Embedfire-stm32f407-batianhu/ebf_stm32f407_batianhu_hardware/hardware/F407板载IC数据手册/4.3寸电容屏/4.3寸液晶模块与STM32F407接线方式.xls

4.5寸液晶模块与野火STM32开发板连接方式，如果只是单独购买了液晶模块，可参考下面的接线方式。
F407霸天虎 |  |  |  | 103霸道 |  |  |  | 103指南者
引脚序号 | 引脚说明 | 引脚名称 | F407（霸天虎） | 引脚序号 | 引脚说明 | 引脚名称 | 103（霸道） | 引脚序号 | 引脚说明 | 引脚名称 | 103（指南者）
1 | GND | 地 | GND | 1 | GND | 地 | GND | 1 | GND | 地 | GND
2 | RES | 复位 | PF11 | 2 | RES | 复位 | PG11 | 2 | RES | 复位 | PE1
3 | D15 | 数据15 | PD10 | 3 | D15 | 数据15 | PD10 | 3 | D15 | 数据15 | PD10
4 | D14 | 数据14 | PD9 | 4 | D14 | 数据14 | PD9 | 4 | D14 | 数据14 | PD9
5 | D13 | 数据13 | PD8 | 5 | D13 | 数据13 | PD8 | 5 | D13 | 数据13 | PD8
6 | D12 | 数据12 | PE15 | 6 | D12 | 数据12 | PE15 | 6 | D12 | 数据12 | PE15
7 | D11 | 数据11 | PE14 | 7 | D11 | 数据11 | PE14 | 7 | D11 | 数据11 | PE14
8 | D10 | 数据10 | PE13 | 8 | D10 | 数据10 | PE13 | 8 | D10 | 数据10 | PE13
9 | D09 | 数据9 | PE12 | 9 | D10 | 数据9 | PE12 | 9 | D10 | 数据9 | PE12
10 | D08 | 数据8 | PE11 | 10 | D08 | 数据8 | PE11 | 10 | D08 | 数据8 | PE11
11 | D07 | 数据7 | PE10 | 11 | D07 | 数据7 | PE10 | 11 | D07 | 数据7 | PE10
12 | D06 | 数据6 | PE9 | 12 | D06 | 数据6 | PE9 | 12 | D06 | 数据6 | PE9
13 | D05 | 数据5 | PE8 | 13 | D05 | 数据5 | PE8 | 13 | D05 | 数据5 | PE8
14 | D04 | 数据4 | PE7 | 14 | D04 | 数据4 | PE7 | 14 | D04 | 数据4 | PE7
15 | D03 | 数据3 | PD1 | 15 | D03 | 数据3 | PD1 | 15 | D03 | 数据3 | PD1
16 | D02 | 数据2 | PD0 | 16 | D02 | 数据2 | PD0 | 16 | D02 | 数据2 | PD0
17 | D01 | 数据1 | PD15 | 17 | D01 | 数据1 | PD15 | 17 | D01 | 数据1 | PD15
18 | D00 | 数据0 | PD14 | 18 | D00 | 数据0 | PD14 | 18 | D00 | 数据0 | PD14
19 | RD | 读使能 | PD4 | 19 | RD | 读使能 | PD4 | 19 | RD | 读使能 | PD4
20 | WR | 写使能 | PD5 | 20 | WR | 写使能 | PD5 | 20 | WR | 写使能 | PD5
21 | RS | 数据命令选择 | PF0 | 21 | RS | 数据命令选择 | PE2 | 21 | RS | 数据命令选择 | PD11
22 | CS | 片选 | PG10 | 22 | CS | 片选 | PG12 | 22 | CS | 片选 | PD7
23 | NC | 空引脚，不需要连接 | PG9 | 23 | NC | 空引脚，不需要连接 | PG9 | 23 | NC | 空引脚，不需要连接 | PG9
24 | SCL | 电容屏时钟:I2C_SCL | PD7 | 24 | SCL | 电容屏时钟:I2C_SCL | PF10 | 24 | SCL | 电容屏时钟:I2C_SCL | PD13
25 | RST | 电容屏复位 | PD6 | 25 | RST | 电容屏复位 | PF11 | 25 | RST | 电容屏复位 | PE3
26 | PD3 | 电容屏数据:I2C_SDA | PD3 | 26 | PD3 | 电容屏数据:I2C_SDA | PF6 | 26 | PD3 | 电容屏数据:I2C_SDA | PE2
27 | INT | 电容屏中断：INT | PG8 | 27 | INT | 电容屏中断：INT | PF9 | 27 | INT | 电容屏中断：INT | PE4
28 | BK | 背光，低电平亮 | PF9 | 28 | BK | 背光，低电平亮 | PG6 | 28 | BK | 背光，低电平亮 | PD12
29 | NC | 悬空 | NC | 29 | NC | 悬空 | NC | 29 | NC | 悬空 | NC
30 | NC | 悬空 | NC | 30 | NC | 悬空 | NC | 30 | NC | 悬空 | NC
31 | 3V3 | 电源 | 3V3 | 31 | 3V3 | 电源 | 3V3 | 31 | 3V3 | 电源 | 3V3
32 | GND | 地 | GND | 32 | GND | 地 | GND | 32 | GND | 地 | GND
