Embedfire-stm32f407-batianhu/ebf_stm32f407_batianhu_hardware/(list of files, cad)

Other CAD files:
hardware/F407_霸天虎V2/封装库/野火_F407霸天虎_V2_0_封装库/CADENCE格式/野火_F407霸天虎_V2_0_PCB封装库_Allegro格式/3215.psm
hardware/F407_霸天虎V2/封装库/野火_F407霸天虎_V2_0_封装库/CADENCE格式/野火_F407霸天虎_V2_0_PCB封装库_Allegro格式/3225.psm
hardware/F407_霸天虎V2/封装库/野火_F407霸天虎_V2_0_封装库/CADENCE格式/野火_F407霸天虎_V2_0_PCB封装库_Allegro格式/ant_dip2.psm
hardware/F407_霸天虎V2/封装库/野火_F407霸天虎_V2_0_封装库/CADENCE格式/野火_F407霸天虎_V2_0_PCB封装库_Allegro格式/ap3216c.psm
hardware/F407_霸天虎V2/封装库/野火_F407霸天虎_V2_0_封装库/CADENCE格式/野火_F407霸天虎_V2_0_PCB封装库_Allegro格式/buzzer.psm
hardware/F407_霸天虎V2/封装库/野火_F407霸天虎_V2_0_封装库/CADENCE格式/野火_F407霸天虎_V2_0_PCB封装库_Allegro格式/c0603.psm
hardware/F407_霸天虎V2/封装库/野火_F407霸天虎_V2_0_封装库/CADENCE格式/野火_F407霸天虎_V2_0_PCB封装库_Allegro格式/cap100.psm
hardware/F407_霸天虎V2/封装库/野火_F407霸天虎_V2_0_封装库/CADENCE格式/野火_F407霸天虎_V2_0_PCB封装库_Allegro格式/con_2pin.psm
hardware/F407_霸天虎V2/封装库/野火_F407霸天虎_V2_0_封装库/CADENCE格式/野火_F407霸天虎_V2_0_PCB封装库_Allegro格式/cr1220.psm
hardware/F407_霸天虎V2/封装库/野火_F407霸天虎_V2_0_封装库/CADENCE格式/野火_F407霸天虎_V2_0_PCB封装库_Allegro格式/d1206.psm
hardware/F407_霸天虎V2/封装库/野火_F407霸天虎_V2_0_封装库/CADENCE格式/野火_F407霸天虎_V2_0_PCB封装库_Allegro格式/db9-f.psm
hardware/F407_霸天虎V2/封装库/野火_F407霸天虎_V2_0_封装库/CADENCE格式/野火_F407霸天虎_V2_0_PCB封装库_Allegro格式/db9-m.psm
hardware/F407_霸天虎V2/封装库/野火_F407霸天虎_V2_0_封装库/CADENCE格式/野火_F407霸天虎_V2_0_PCB封装库_Allegro格式/dip-2x10-2p54.psm
hardware/F407_霸天虎V2/封装库/野火_F407霸天虎_V2_0_封装库/CADENCE格式/野火_F407霸天虎_V2_0_PCB封装库_Allegro格式/dip-2x16-2p54.psm
hardware/F407_霸天虎V2/封装库/野火_F407霸天虎_V2_0_封装库/CADENCE格式/野火_F407霸天虎_V2_0_PCB封装库_Allegro格式/dip-2x302p54.psm
hardware/F407_霸天虎V2/封装库/野火_F407霸天虎_V2_0_封装库/CADENCE格式/野火_F407霸天虎_V2_0_PCB封装库_Allegro格式/dip-2x4-2p54.psm
hardware/F407_霸天虎V2/封装库/野火_F407霸天虎_V2_0_封装库/CADENCE格式/野火_F407霸天虎_V2_0_PCB封装库_Allegro格式/do214.psm
hardware/F407_霸天虎V2/封装库/野火_F407霸天虎_V2_0_封装库/CADENCE格式/野火_F407霸天虎_V2_0_PCB封装库_Allegro格式/ear_jack.psm
hardware/F407_霸天虎V2/封装库/野火_F407霸天虎_V2_0_封装库/CADENCE格式/野火_F407霸天虎_V2_0_PCB封装库_Allegro格式/ec6p3.psm
hardware/F407_霸天虎V2/封装库/野火_F407霸天虎_V2_0_封装库/CADENCE格式/野火_F407霸天虎_V2_0_PCB封装库_Allegro格式/f0805.psm
hardware/F407_霸天虎V2/封装库/野火_F407霸天虎_V2_0_封装库/CADENCE格式/野火_F407霸天虎_V2_0_PCB封装库_Allegro格式/gxd.psm
hardware/F407_霸天虎V2/封装库/野火_F407霸天虎_V2_0_封装库/CADENCE格式/野火_F407霸天虎_V2_0_PCB封装库_Allegro格式/hdr102.psm
hardware/F407_霸天虎V2/封装库/野火_F407霸天虎_V2_0_封装库/CADENCE格式/野火_F407霸天虎_V2_0_PCB封装库_Allegro格式/jack-2_5mm_b.psm
hardware/F407_霸天虎V2/封装库/野火_F407霸天虎_V2_0_封装库/CADENCE格式/野火_F407霸天虎_V2_0_PCB封装库_Allegro格式/jtag_20pin.psm
hardware/F407_霸天虎V2/封装库/野火_F407霸天虎_V2_0_封装库/CADENCE格式/野火_F407霸天虎_V2_0_PCB封装库_Allegro格式/l0603.psm
hardware/F407_霸天虎V2/封装库/野火_F407霸天虎_V2_0_封装库/CADENCE格式/野火_F407霸天虎_V2_0_PCB封装库_Allegro格式/l1040.psm
hardware/F407_霸天虎V2/封装库/野火_F407霸天虎_V2_0_封装库/CADENCE格式/野火_F407霸天虎_V2_0_PCB封装库_Allegro格式/led0603.psm
hardware/F407_霸天虎V2/封装库/野火_F407霸天虎_V2_0_封装库/CADENCE格式/野火_F407霸天虎_V2_0_PCB封装库_Allegro格式/led_rgb_5mm.psm
hardware/F407_霸天虎V2/封装库/野火_F407霸天虎_V2_0_封装库/CADENCE格式/野火_F407霸天虎_V2_0_PCB封装库_Allegro格式/lqfp144-050-2020.psm
hardware/F407_霸天虎V2/封装库/野火_F407霸天虎_V2_0_封装库/CADENCE格式/野火_F407霸天虎_V2_0_PCB封装库_Allegro格式/mic_6x2_2.psm
hardware/F407_霸天虎V2/封装库/野火_F407霸天虎_V2_0_封装库/CADENCE格式/野火_F407霸天虎_V2_0_PCB封装库_Allegro格式/micro_usb_5s.psm
hardware/F407_霸天虎V2/封装库/野火_F407霸天虎_V2_0_封装库/CADENCE格式/野火_F407霸天虎_V2_0_PCB封装库_Allegro格式/mini_usb_5s.psm
hardware/F407_霸天虎V2/封装库/野火_F407霸天虎_V2_0_封装库/CADENCE格式/野火_F407霸天虎_V2_0_PCB封装库_Allegro格式/ph-1x2-2p0.psm
hardware/F407_霸天虎V2/封装库/野火_F407霸天虎_V2_0_封装库/CADENCE格式/野火_F407霸天虎_V2_0_PCB封装库_Allegro格式/qfn24.psm
hardware/F407_霸天虎V2/封装库/野火_F407霸天虎_V2_0_封装库/CADENCE格式/野火_F407霸天虎_V2_0_PCB封装库_Allegro格式/qfn32-050-3r7x3r7.psm
hardware/F407_霸天虎V2/封装库/野火_F407霸天虎_V2_0_封装库/CADENCE格式/野火_F407霸天虎_V2_0_PCB封装库_Allegro格式/qfn32.psm
hardware/F407_霸天虎V2/封装库/野火_F407霸天虎_V2_0_封装库/CADENCE格式/野火_F407霸天虎_V2_0_PCB封装库_Allegro格式/r0603.psm
hardware/F407_霸天虎V2/封装库/野火_F407霸天虎_V2_0_封装库/CADENCE格式/野火_F407霸天虎_V2_0_PCB封装库_Allegro格式/rj45.psm
hardware/F407_霸天虎V2/封装库/野火_F407霸天虎_V2_0_封装库/CADENCE格式/野火_F407霸天虎_V2_0_PCB封装库_Allegro格式/rm065-v1.psm
hardware/F407_霸天虎V2/封装库/野火_F407霸天虎_V2_0_封装库/CADENCE格式/野火_F407霸天虎_V2_0_PCB封装库_Allegro格式/sip3-2p54.psm
hardware/F407_霸天虎V2/封装库/野火_F407霸天虎_V2_0_封装库/CADENCE格式/野火_F407霸天虎_V2_0_PCB封装库_Allegro格式/sip4-2p54.psm
hardware/F407_霸天虎V2/封装库/野火_F407霸天虎_V2_0_封装库/CADENCE格式/野火_F407霸天虎_V2_0_PCB封装库_Allegro格式/sip6-2p54.psm
hardware/F407_霸天虎V2/封装库/野火_F407霸天虎_V2_0_封装库/CADENCE格式/野火_F407霸天虎_V2_0_PCB封装库_Allegro格式/smc.psm
hardware/F407_霸天虎V2/封装库/野火_F407霸天虎_V2_0_封装库/CADENCE格式/野火_F407霸天虎_V2_0_PCB封装库_Allegro格式/sod323.psm
hardware/F407_霸天虎V2/封装库/野火_F407霸天虎_V2_0_封装库/CADENCE格式/野火_F407霸天虎_V2_0_PCB封装库_Allegro格式/sod523.psm
hardware/F407_霸天虎V2/封装库/野火_F407霸天虎_V2_0_封装库/CADENCE格式/野火_F407霸天虎_V2_0_PCB封装库_Allegro格式/soic16.psm
hardware/F407_霸天虎V2/封装库/野火_F407霸天虎_V2_0_封装库/CADENCE格式/野火_F407霸天虎_V2_0_PCB封装库_Allegro格式/soic8-208.psm
hardware/F407_霸天虎V2/封装库/野火_F407霸天虎_V2_0_封装库/CADENCE格式/野火_F407霸天虎_V2_0_PCB封装库_Allegro格式/soic8e.psm
hardware/F407_霸天虎V2/封装库/野火_F407霸天虎_V2_0_封装库/CADENCE格式/野火_F407霸天虎_V2_0_PCB封装库_Allegro格式/sop8.psm
hardware/F407_霸天虎V2/封装库/野火_F407霸天虎_V2_0_封装库/CADENCE格式/野火_F407霸天虎_V2_0_PCB封装库_Allegro格式/sot-353.psm
hardware/F407_霸天虎V2/封装库/野火_F407霸天虎_V2_0_封装库/CADENCE格式/野火_F407霸天虎_V2_0_PCB封装库_Allegro格式/sot23-5.psm
hardware/F407_霸天虎V2/封装库/野火_F407霸天虎_V2_0_封装库/CADENCE格式/野火_F407霸天虎_V2_0_PCB封装库_Allegro格式/sot23.psm
hardware/F407_霸天虎V2/封装库/野火_F407霸天虎_V2_0_封装库/CADENCE格式/野火_F407霸天虎_V2_0_PCB封装库_Allegro格式/sw4_pb_esw_sm_p177.psm
hardware/F407_霸天虎V2/封装库/野火_F407霸天虎_V2_0_封装库/CADENCE格式/野火_F407霸天虎_V2_0_PCB封装库_Allegro格式/switch_ddsz.psm
hardware/F407_霸天虎V2/封装库/野火_F407霸天虎_V2_0_封装库/CADENCE格式/野火_F407霸天虎_V2_0_PCB封装库_Allegro格式/t4r2-6r2_botsmt.psm
hardware/F407_霸天虎V2/封装库/野火_F407霸天虎_V2_0_封装库/CADENCE格式/野火_F407霸天虎_V2_0_PCB封装库_Allegro格式/t4r2-6r2_topsmt.psm
hardware/F407_霸天虎V2/封装库/野火_F407霸天虎_V2_0_封装库/CADENCE格式/野火_F407霸天虎_V2_0_PCB封装库_Allegro格式/tfcard.psm
hardware/F407_霸天虎V2/封装库/野火_F407霸天虎_V2_0_封装库/CADENCE格式/野火_F407霸天虎_V2_0_PCB封装库_Allegro格式/to252-2.psm
hardware/F407_霸天虎V2/封装库/野火_F407霸天虎_V2_0_封装库/CADENCE格式/野火_F407霸天虎_V2_0_PCB封装库_Allegro格式/tsop44-080-400.psm
hardware/F407_霸天虎V2/封装库/野火_F407霸天虎_V2_0_封装库/CADENCE格式/野火_F407霸天虎_V2_0_PCB封装库_Allegro格式/usb-a-sm.psm
hardware/F407_霸天虎V2/封装库/野火_F407霸天虎_V2_0_封装库/CADENCE格式/野火_F407霸天虎_V2_0_PCB封装库_Allegro格式/wf_pad.psm
hardware/F407_霸天虎V2/封装库/野火_F407霸天虎_V2_0_封装库/CADENCE格式/野火_F407霸天虎_V2_0_PCB封装库_Allegro格式/xh2p54-5p_90.psm
hardware/F407_霸天虎V2/封装库/野火_F407霸天虎_V2_0_封装库/CADENCE格式/野火_F407霸天虎_V2_0_PCB封装库_Allegro格式/xtal-dip.psm
hardware/F407_霸天虎V2/封装库/野火_F407霸天虎_V2_0_封装库/CADENCE格式/野火_F407霸天虎_V2_0_PCB封装库_Allegro格式/xtal_smd.psm
