Embedfire-stm32f407-batianhu/ebf_stm32f407_batianhu_hardware/hardware/F407_霸天虎V2/原理图/野火_F407霸天虎_原理图_V2.0.pdf

D

C

B

A | A

目录

# Page 1 目录

# 野火_F407霸天虎_原理图_V2.0

# Page 2

# Page 3

# Page 4

# Page 5

# Page 6

# Page 8

# Page 7

# 历史版本

# 主电源

## MCU_GPIO

## 液晶屏/WIFI

# 引出IO/启动设置

## 串口/RS485/CAN

## 摄像头/SPI闪存/EEPROM

# Page 9 以太网

# Page 10

# Page 11

# 传感器/按键/LED

音频

## Page 12 SRAM/ISP/USB/JTAG/SWD

Title

Size | Document Number | Rev
Date: | Sheet | of
目录 | V2.0

野火_F407霸天虎_原理图

东莞野火电子技术有限公司
https://fire-stm32.taobao.com

A4

Tuesday, March 12, 2019 | 1 | 12

Title

目录 | V2.0

野火_F407霸天虎_原理图

东莞野火电子技术有限公司
https://fire-stm32.taobao.com
Tuesday, March 12, 2019 | 1 | 12

Title

目录 | V2.0

野火_F407霸天虎_原理图

东莞野火电子技术有限公司
https://fire-stm32.taobao.com
Tuesday, March 12, 2019 | 1 | 12

D

C

B

A | A

# 历史版本

# 版本号

V1.0 | 2017-12-1
| 日期 | 设计 | 描述
| | cancore | 初始版本
V2.0 | 2018-12-22 | cancore | 更新结构，增加一个RS232串口，增加一个EBF Module接口

Title

历史版本 | V2.0

野火_F407霸天虎_原理图

东莞野火电子技术有限公司
https://fire-stm32.taobao.com
Tuesday, March 12, 2019 | 2 | 12

Title

历史版本 | V2.0

野火_F407霸天虎_原理图

东莞野火电子技术有限公司
https://fire-stm32.taobao.com
Tuesday, March 12, 2019 | 2 | 12

Title

历史版本 | V2.0

野火_F407霸天虎_原理图

东莞野火电子技术有限公司
https://fire-stm32.taobao.com
Tuesday, March 12, 2019 | 2 | 12

D

# 外部电源供电时断开USB供电，

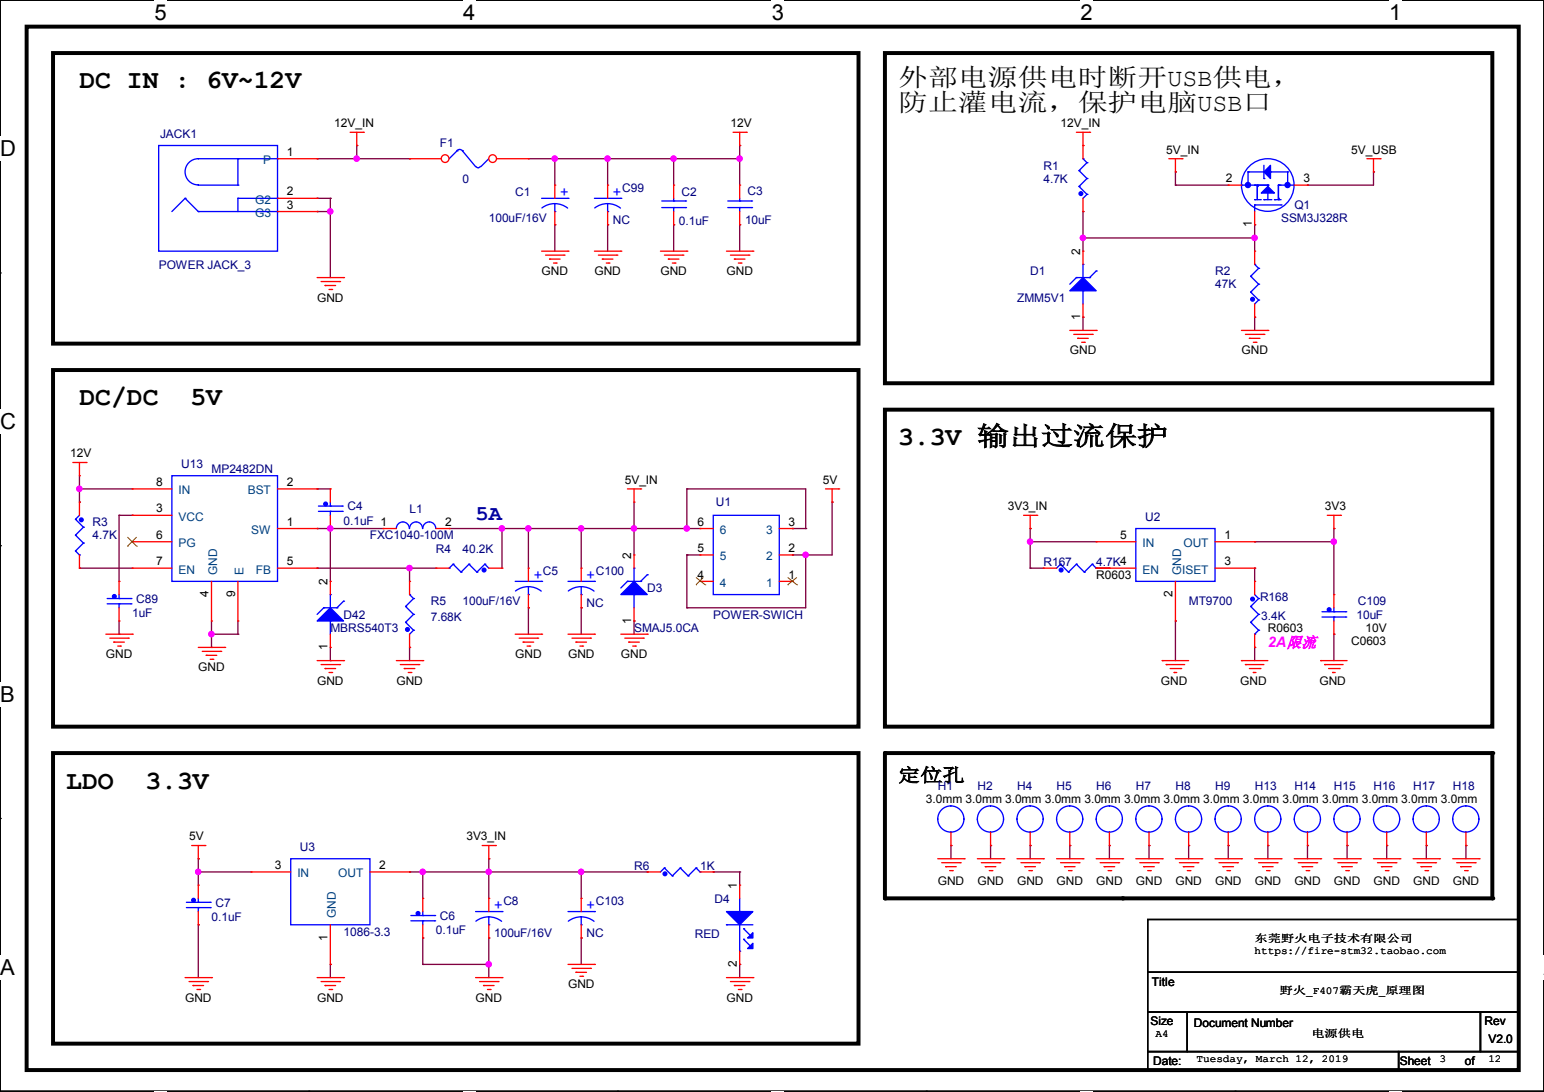
[picture p3: page 3]

GND GND

东莞野火电子技术有限公司
https://fire-stm32.taobao.com

D

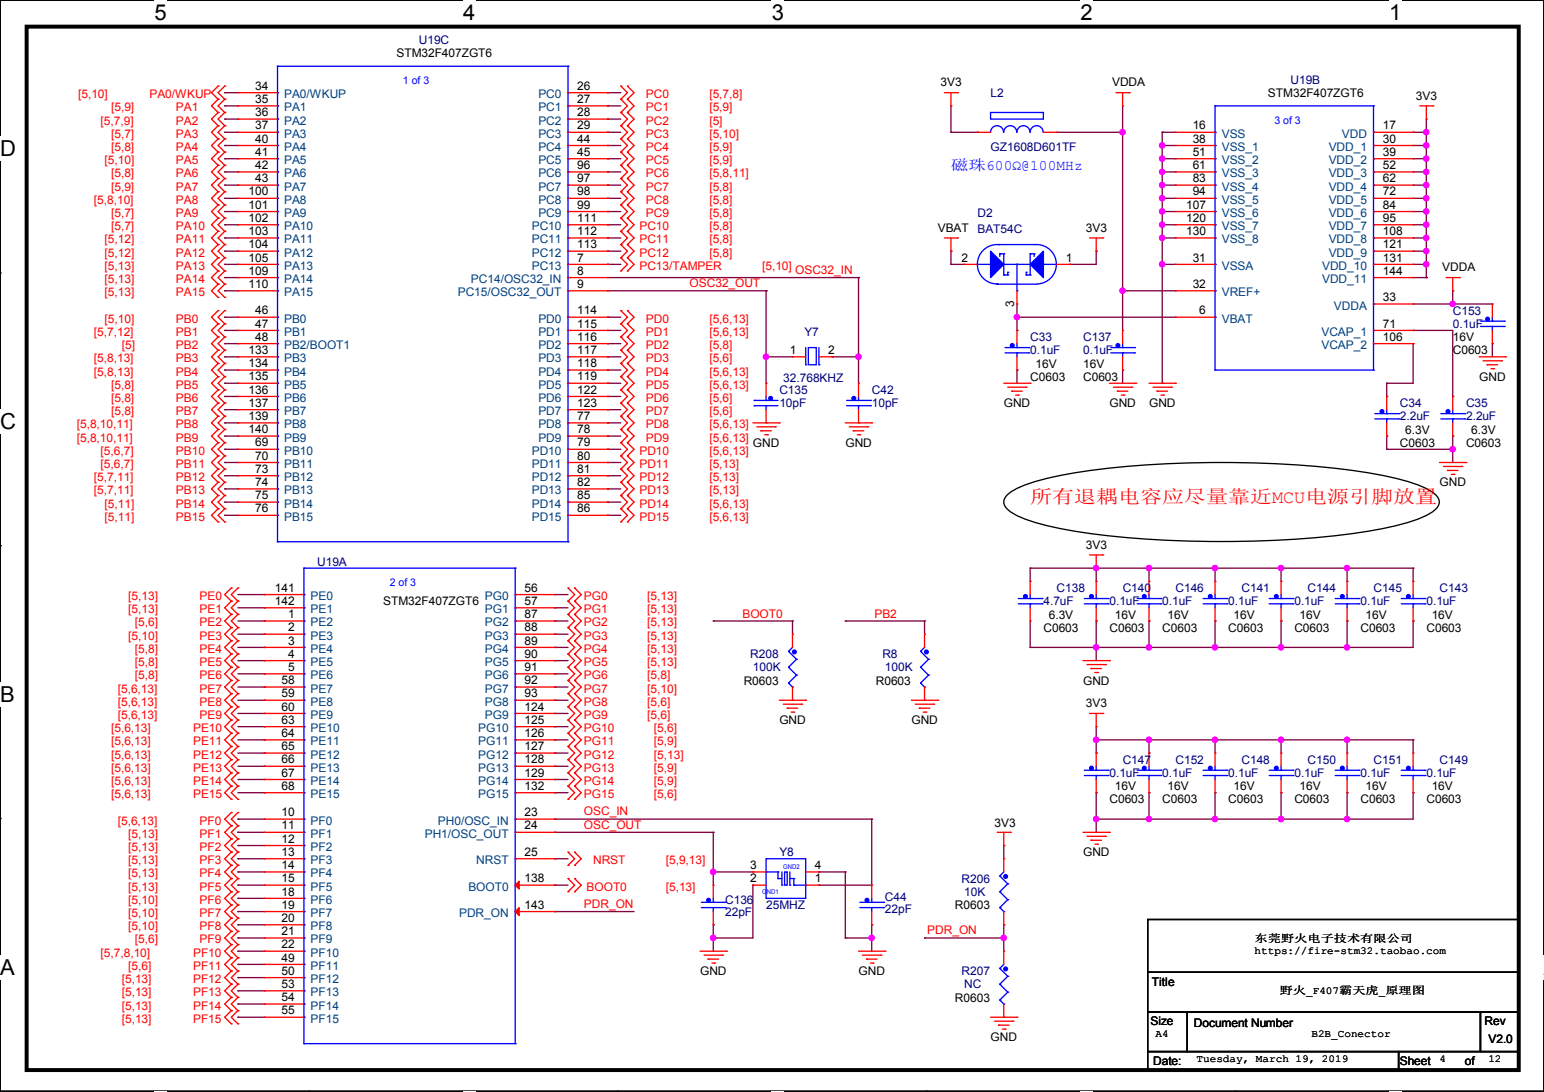
[picture p4: page 4]

东莞野火电子技术有限公司
https://fire-stm32.taobao.com

D

# 引出IO口

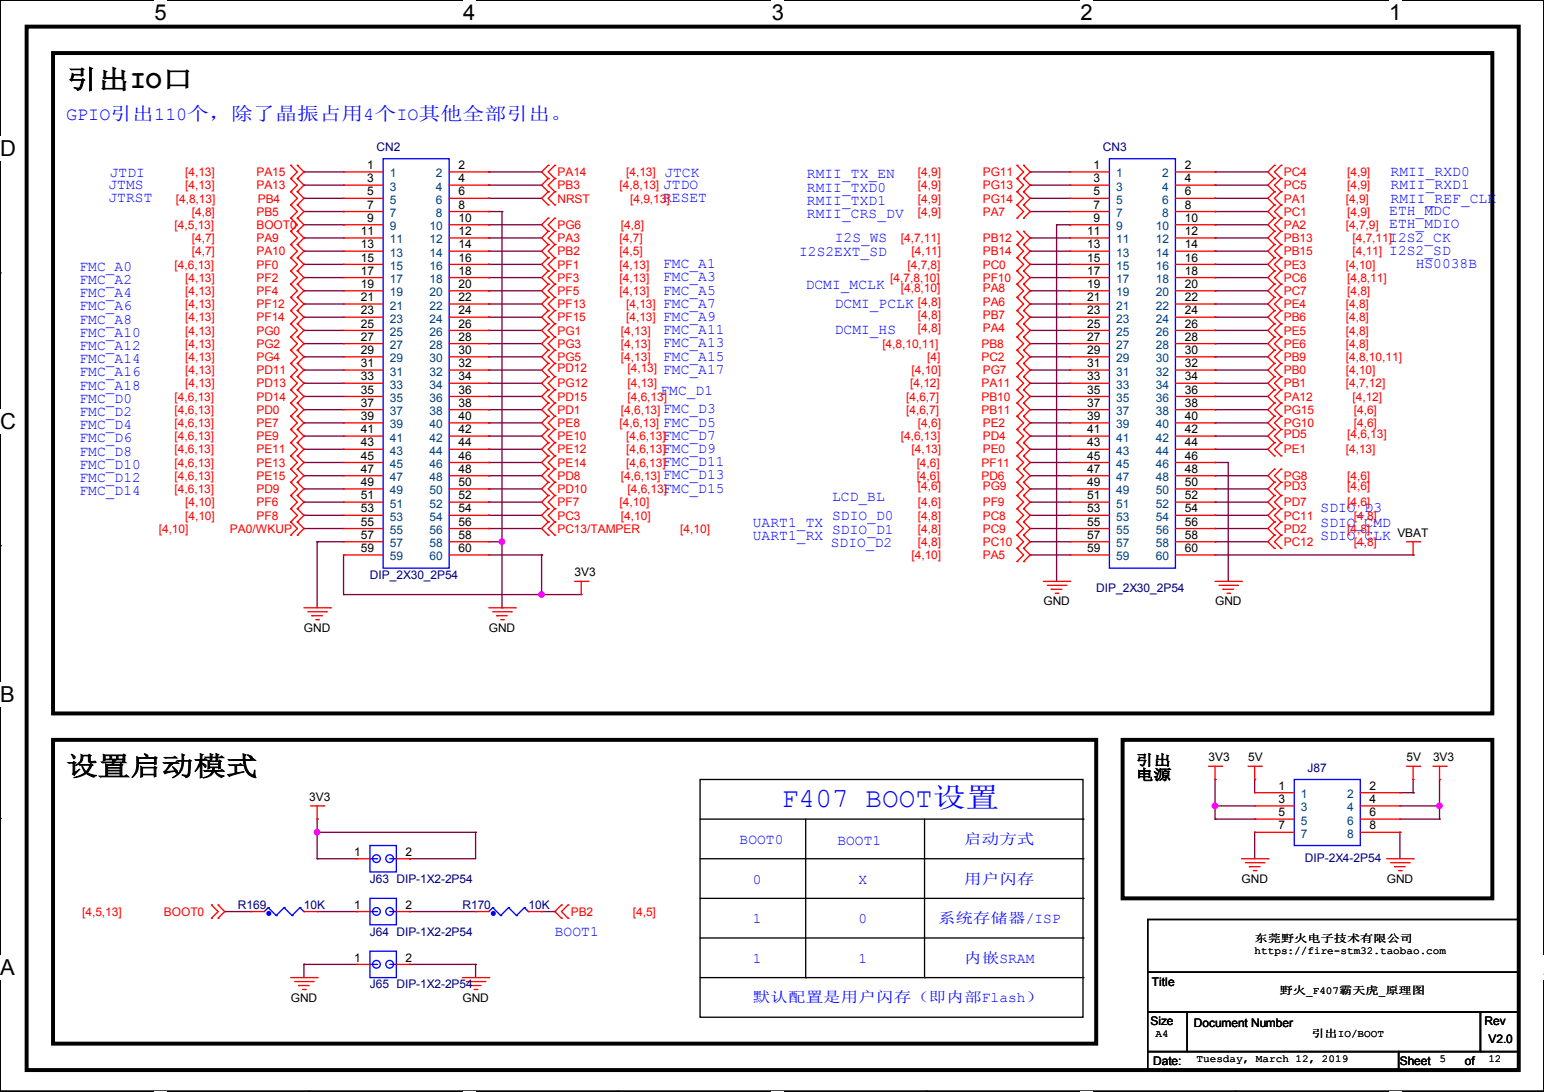
[picture p5: page 5]

东莞野火电子技术有限公司
https://fire-stm32.taobao.com

D

# 液晶接口-FSMC-8080模式

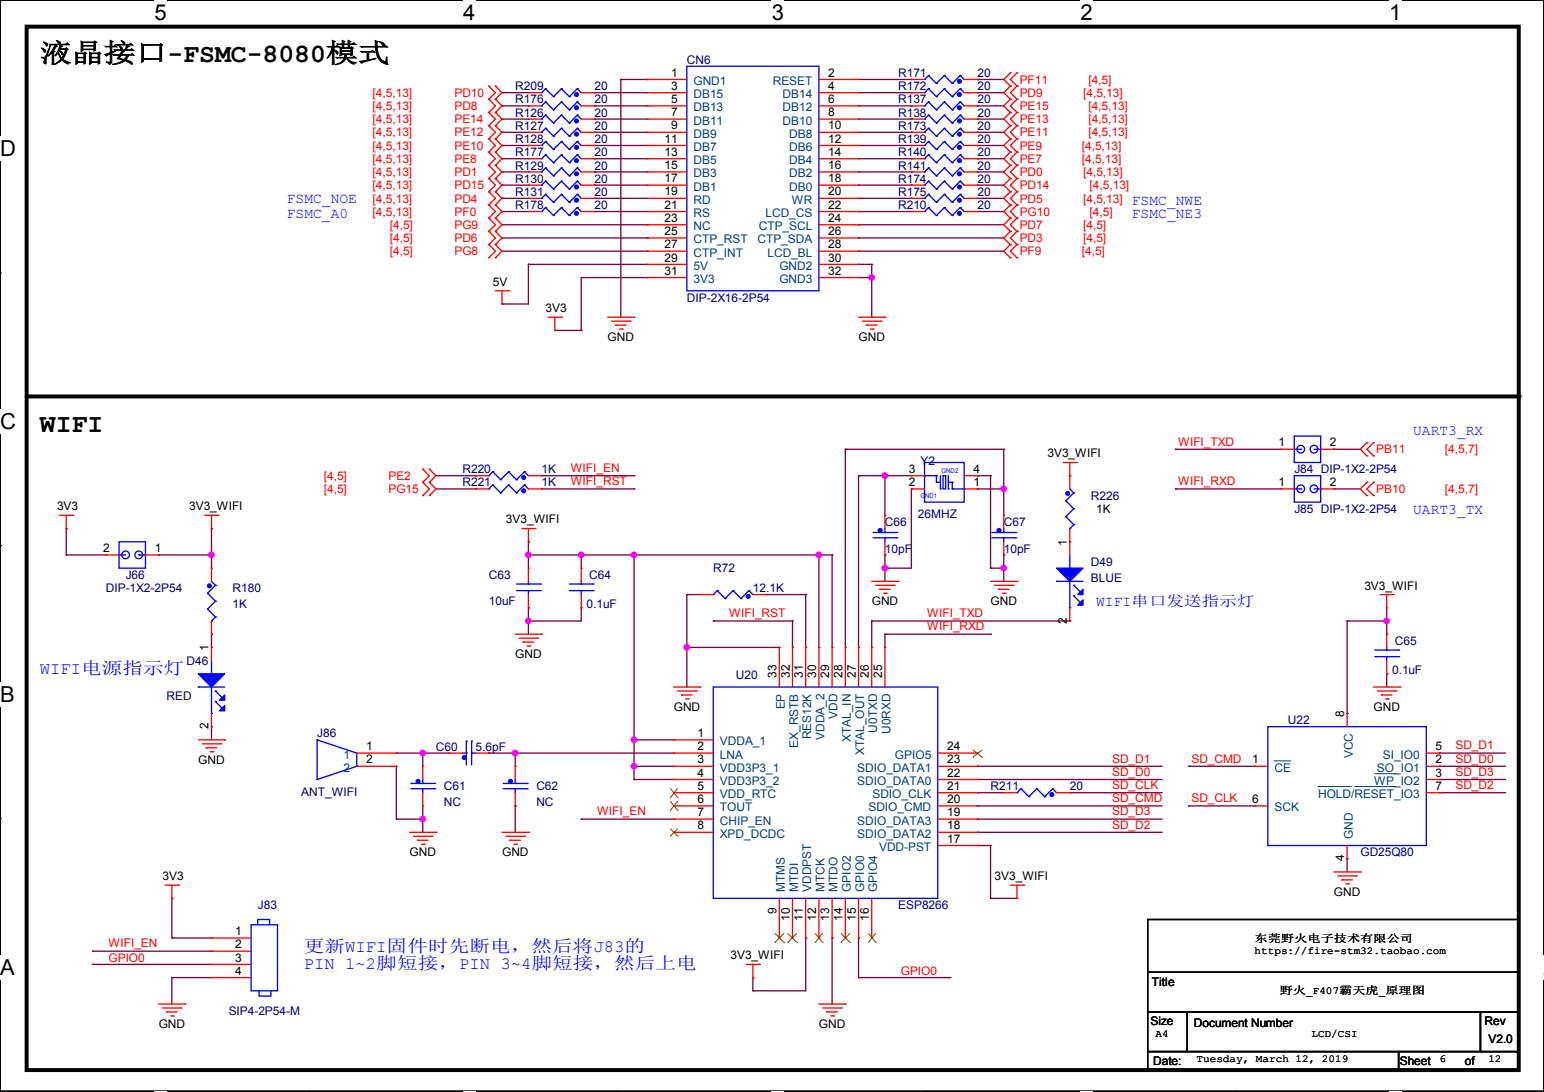
[picture p6: page 6]

东莞野火电子技术有限公司
https://fire-stm32.taobao.com

D

USB转串口 | RS232串口

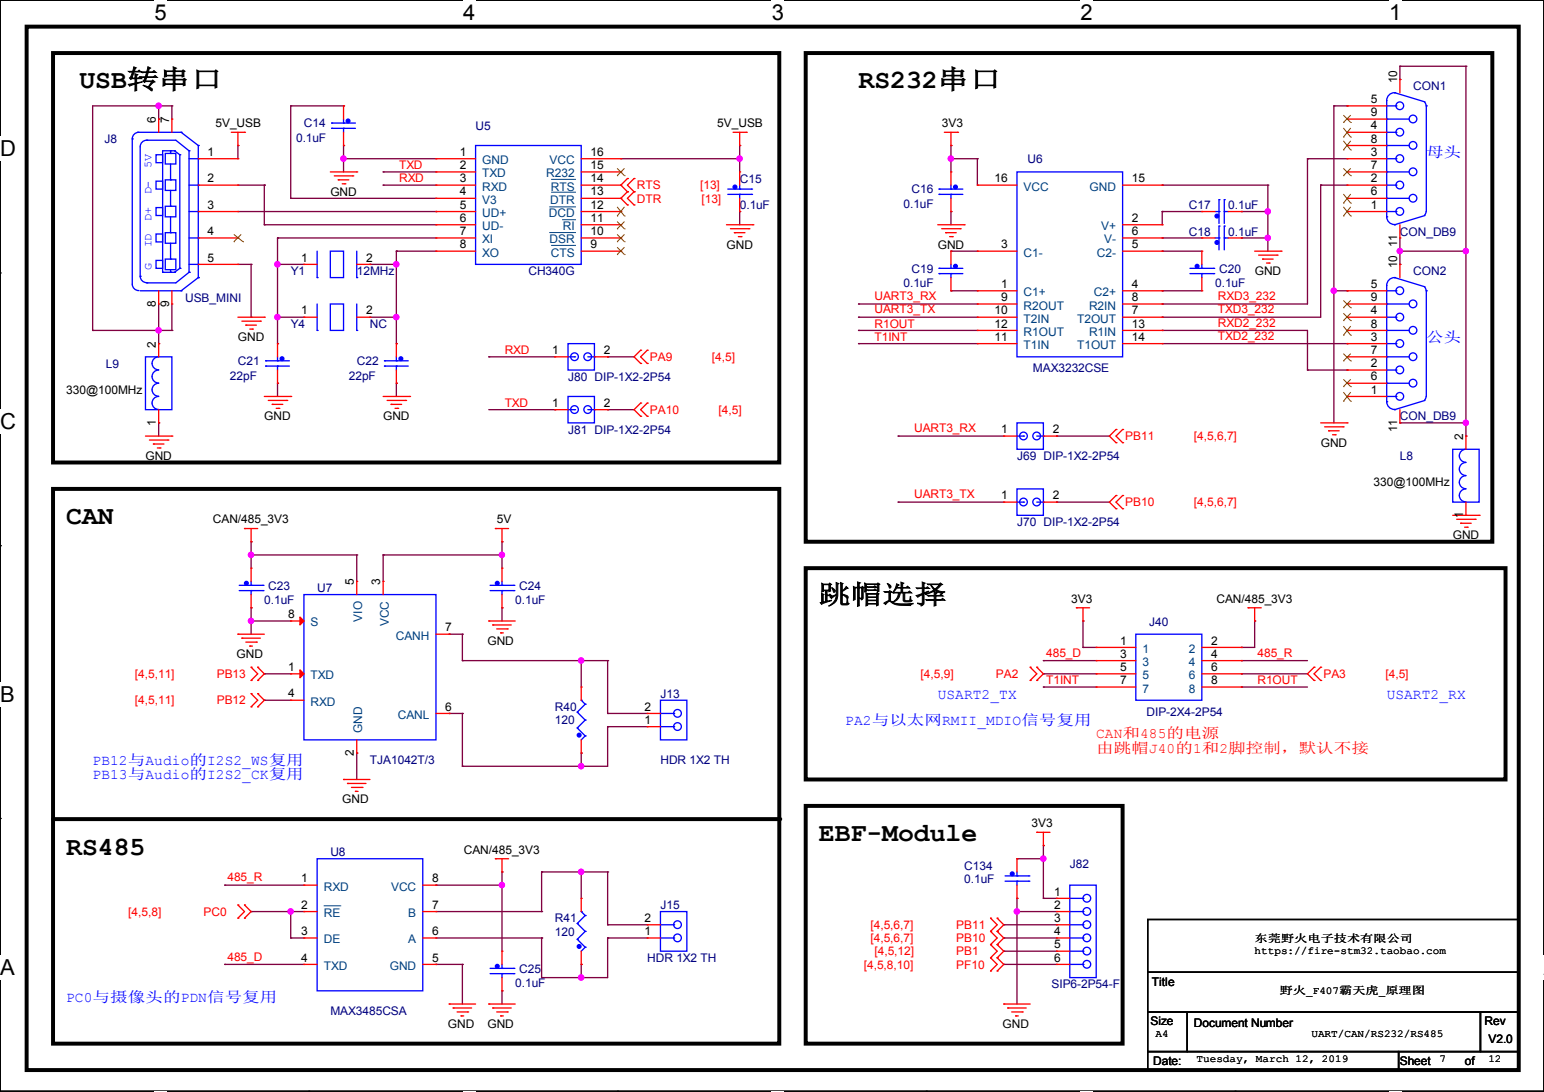
[picture p7: page 7]

东莞野火电子技术有限公司
https://fire-stm32.taobao.com

D

# SD卡

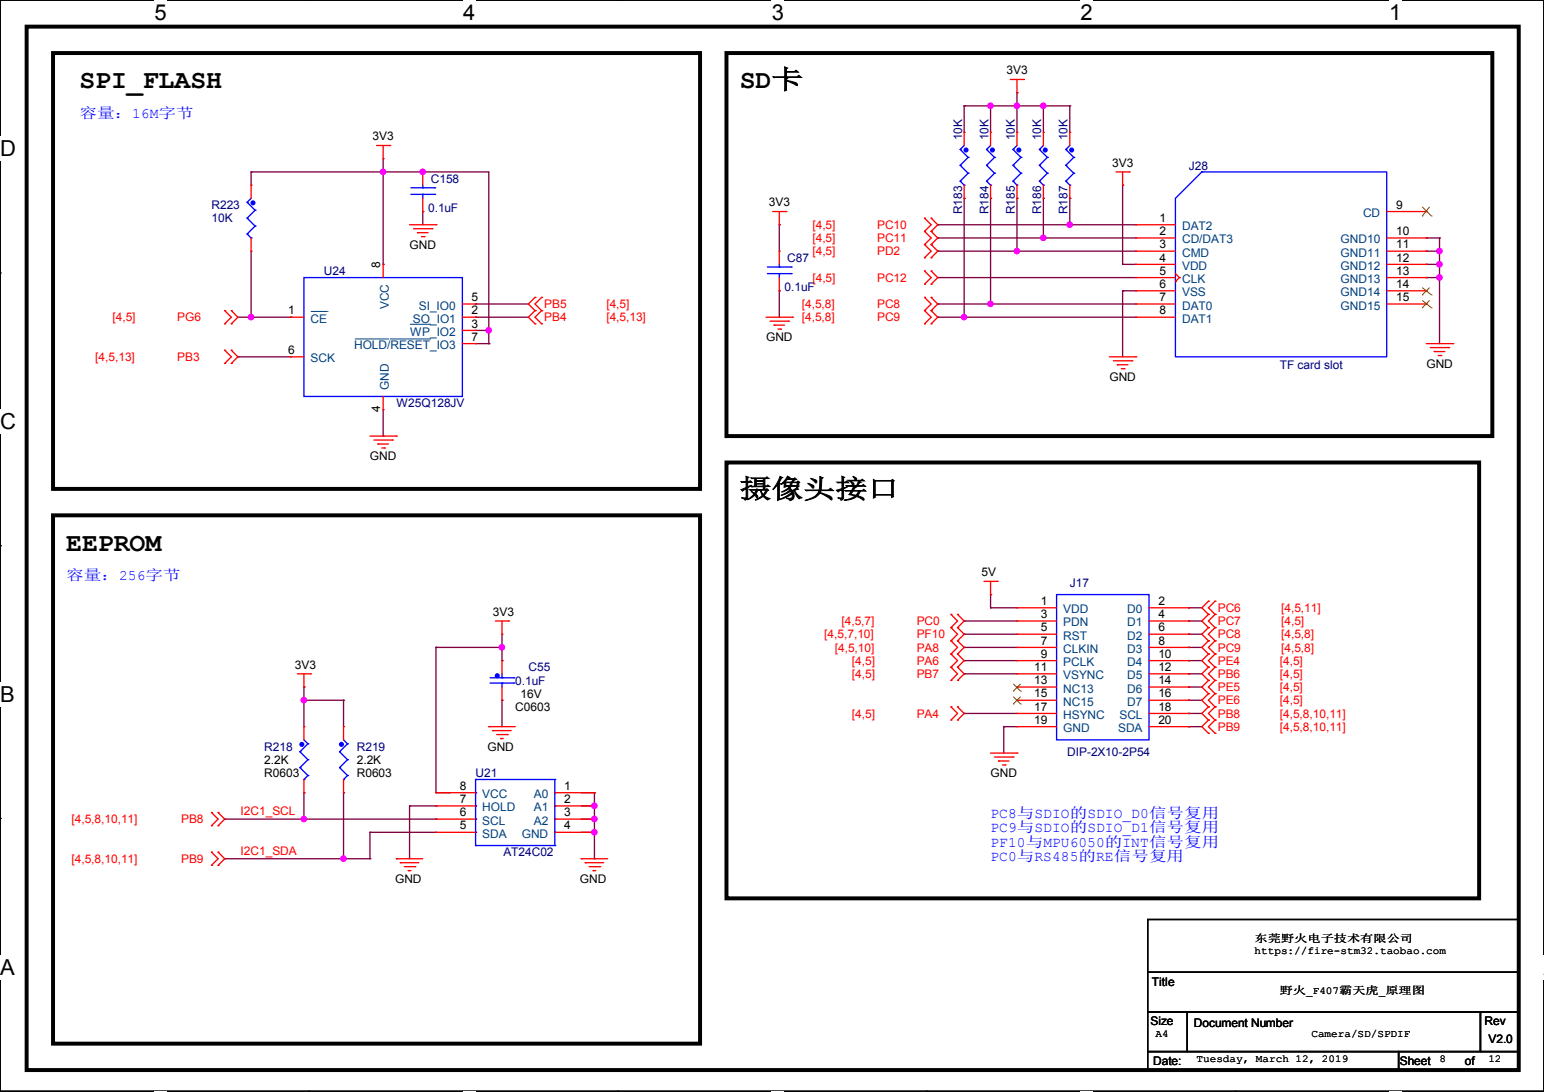
[picture p8: page 8]

东莞野火电子技术有限公司
https://fire-stm32.taobao.com

D

# 以太网接口

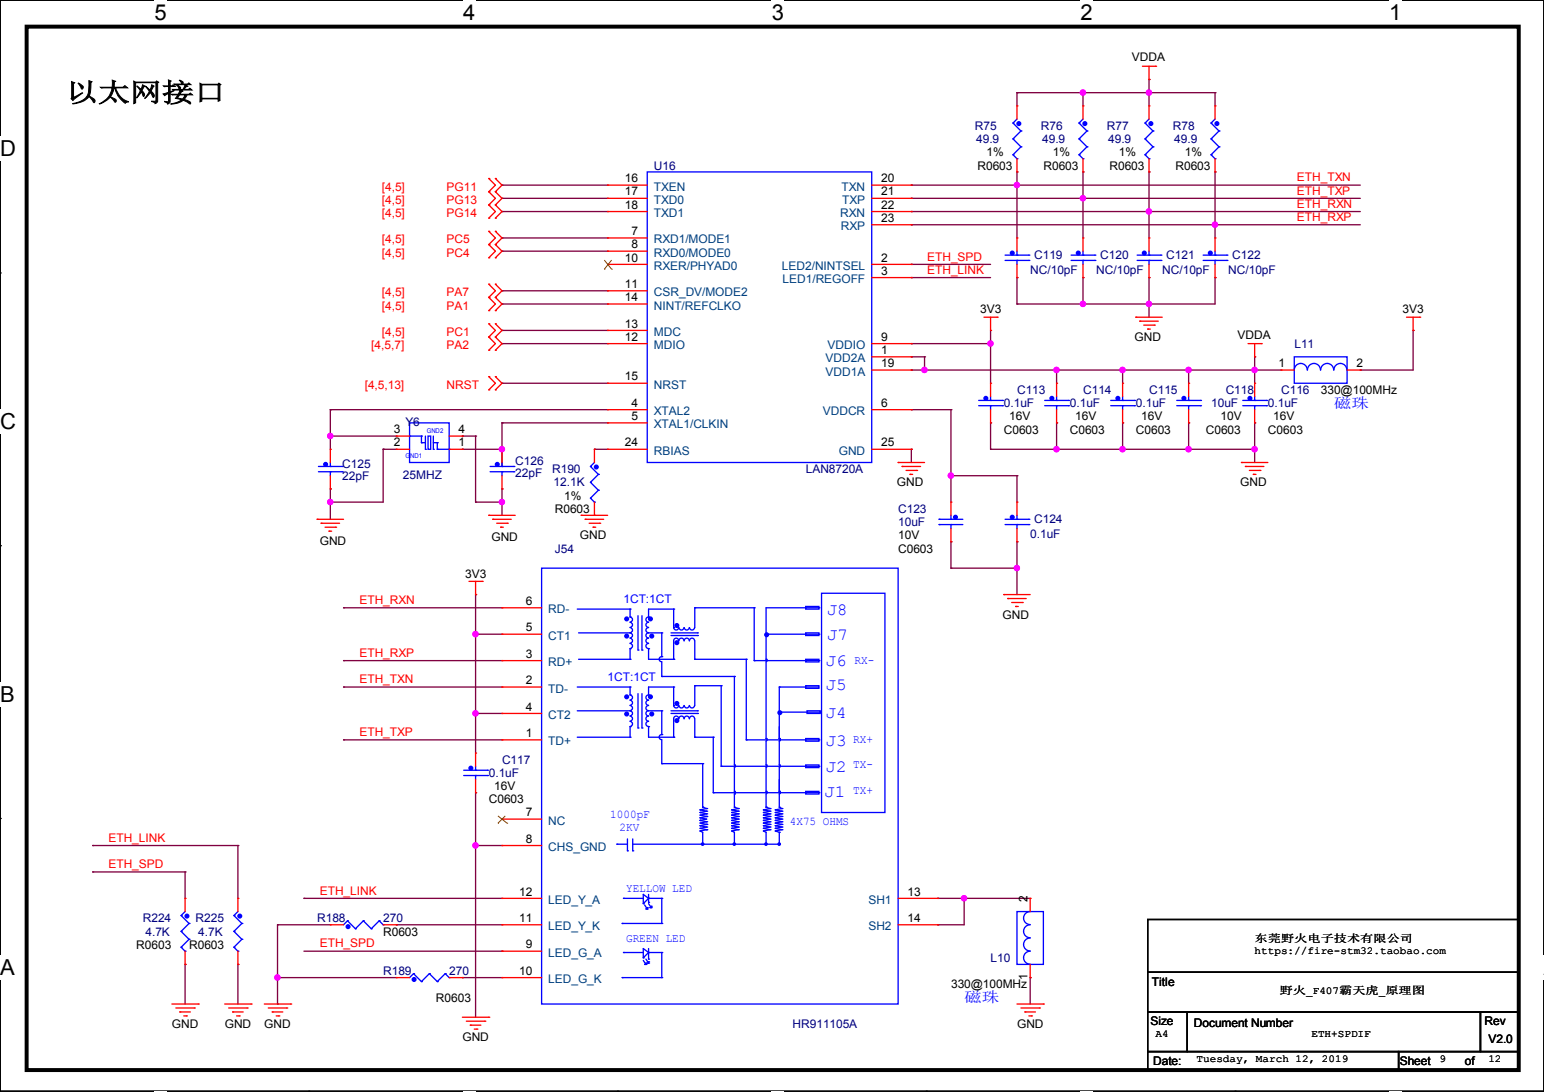
[picture p9: page 9]

东莞野火电子技术有限公司
https://fire-stm32.taobao.com

D

# 六轴传感器

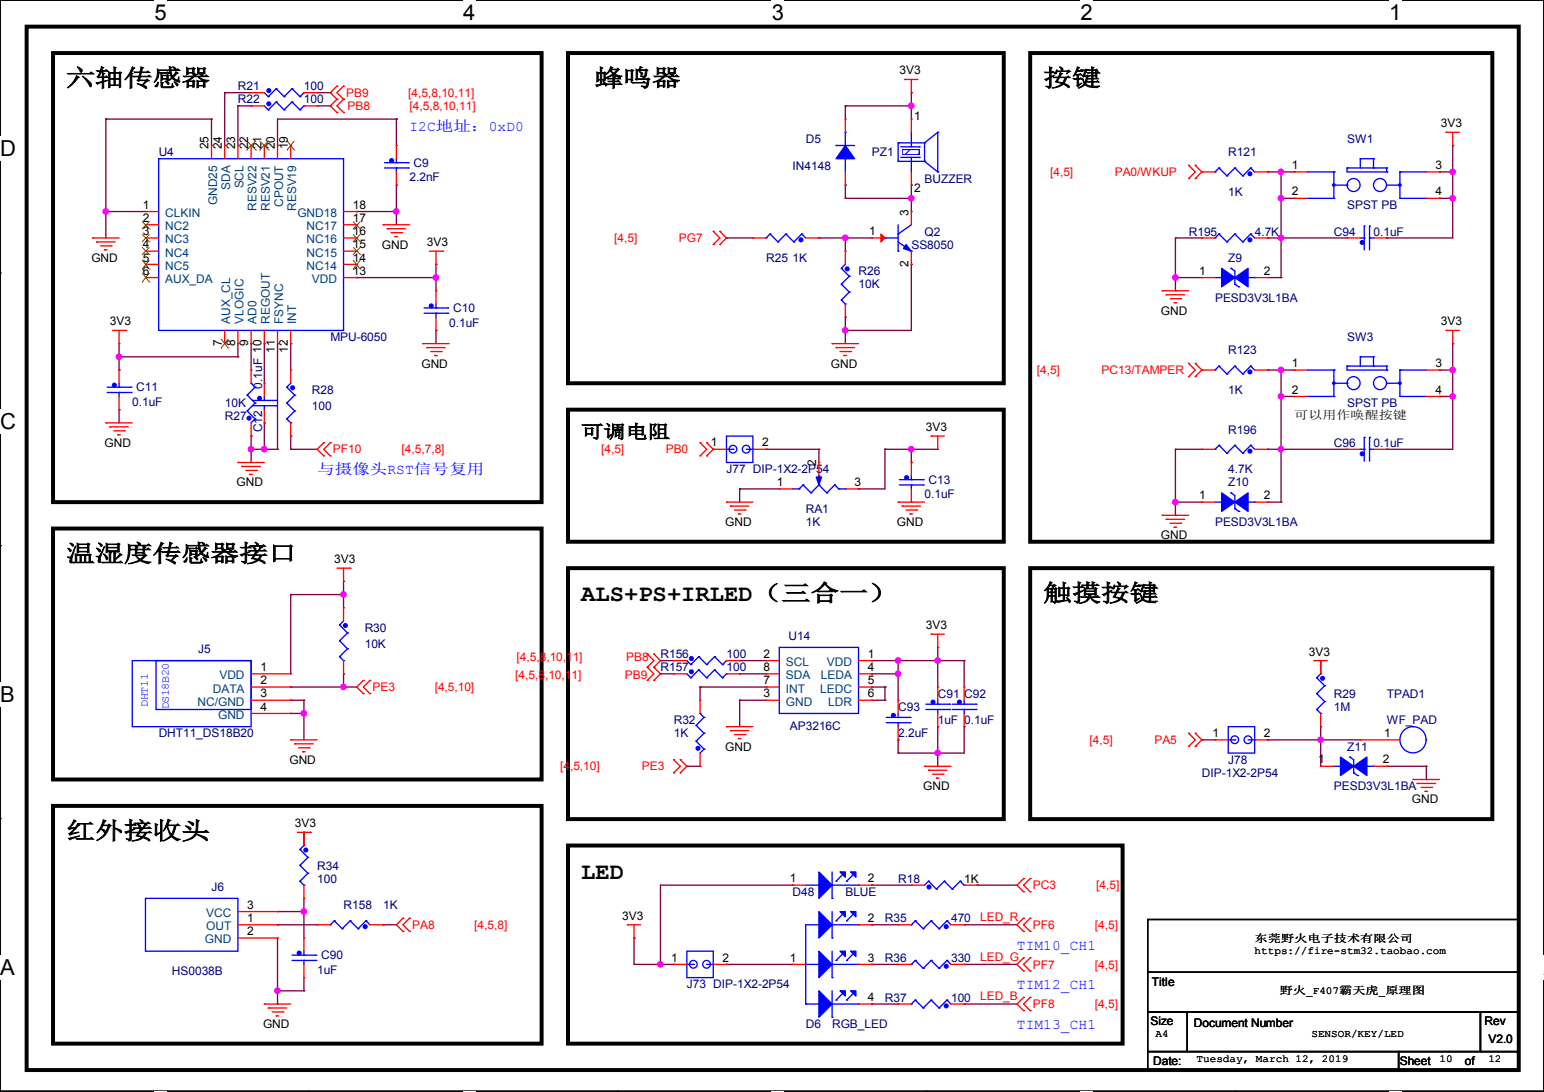
[picture p10: page 10]

ALS+PS+IRLED（三合一）

东莞野火电子技术有限公司
https://fire-stm32.taobao.com

D

# 音频输入

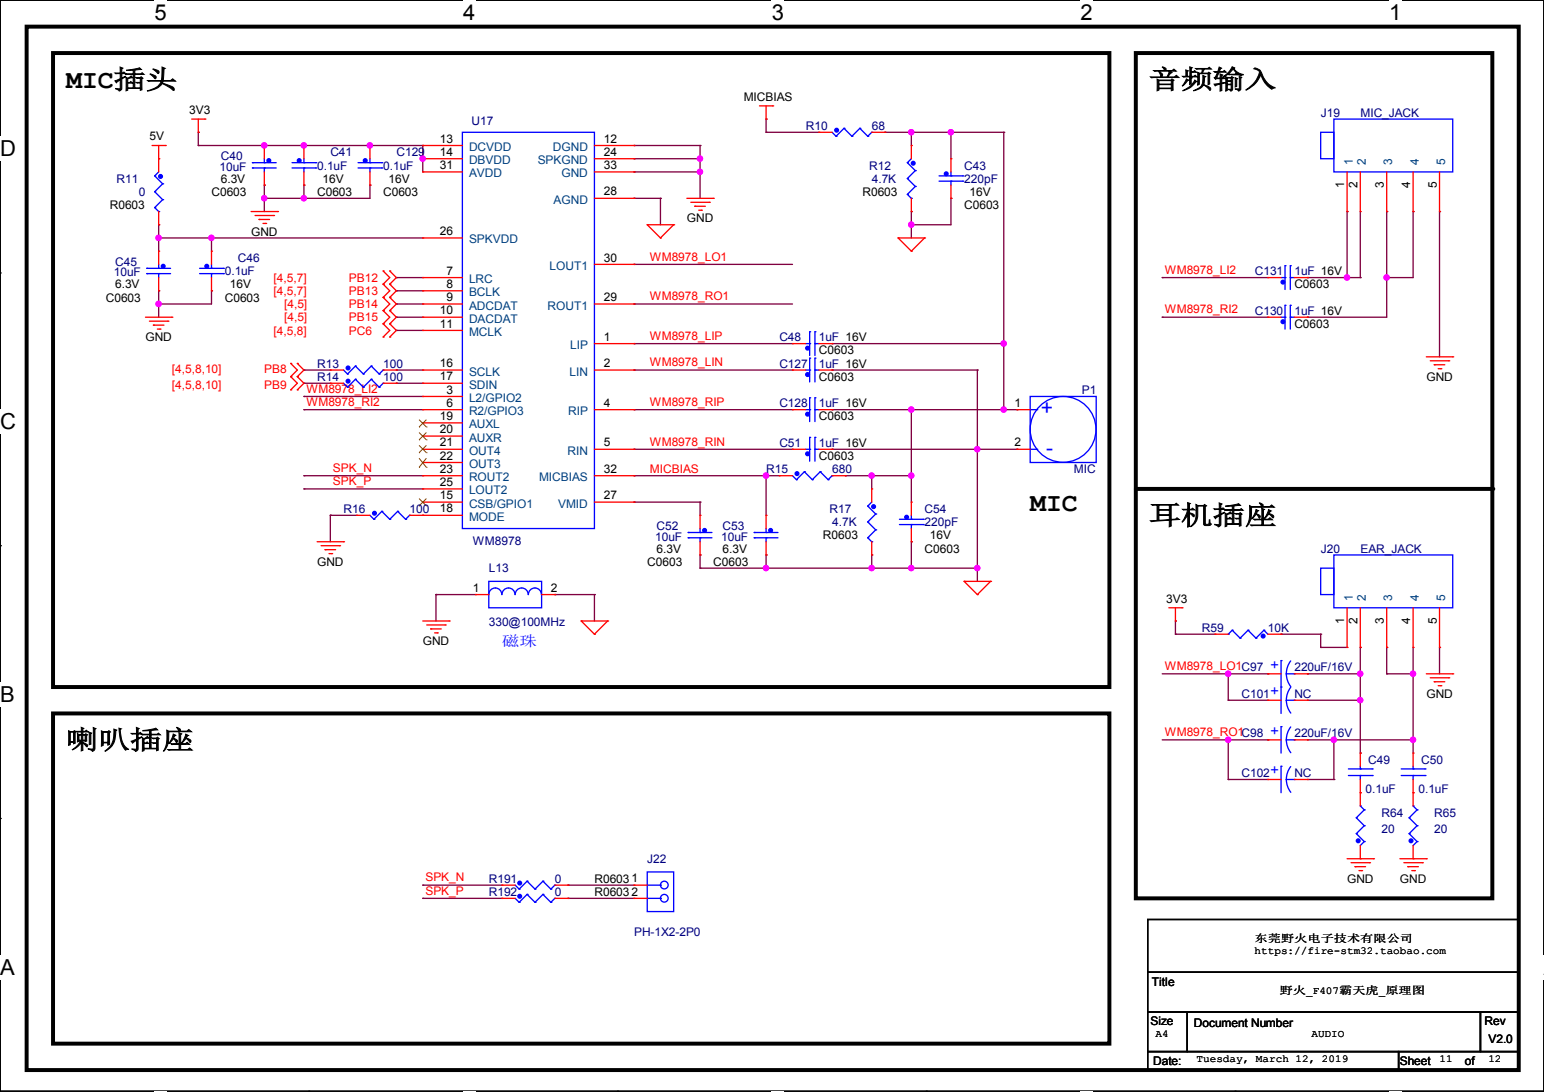
[picture p11: page 11]

东莞野火电子技术有限公司
https://fire-stm32.taobao.com

D

# ISP一键下载电路

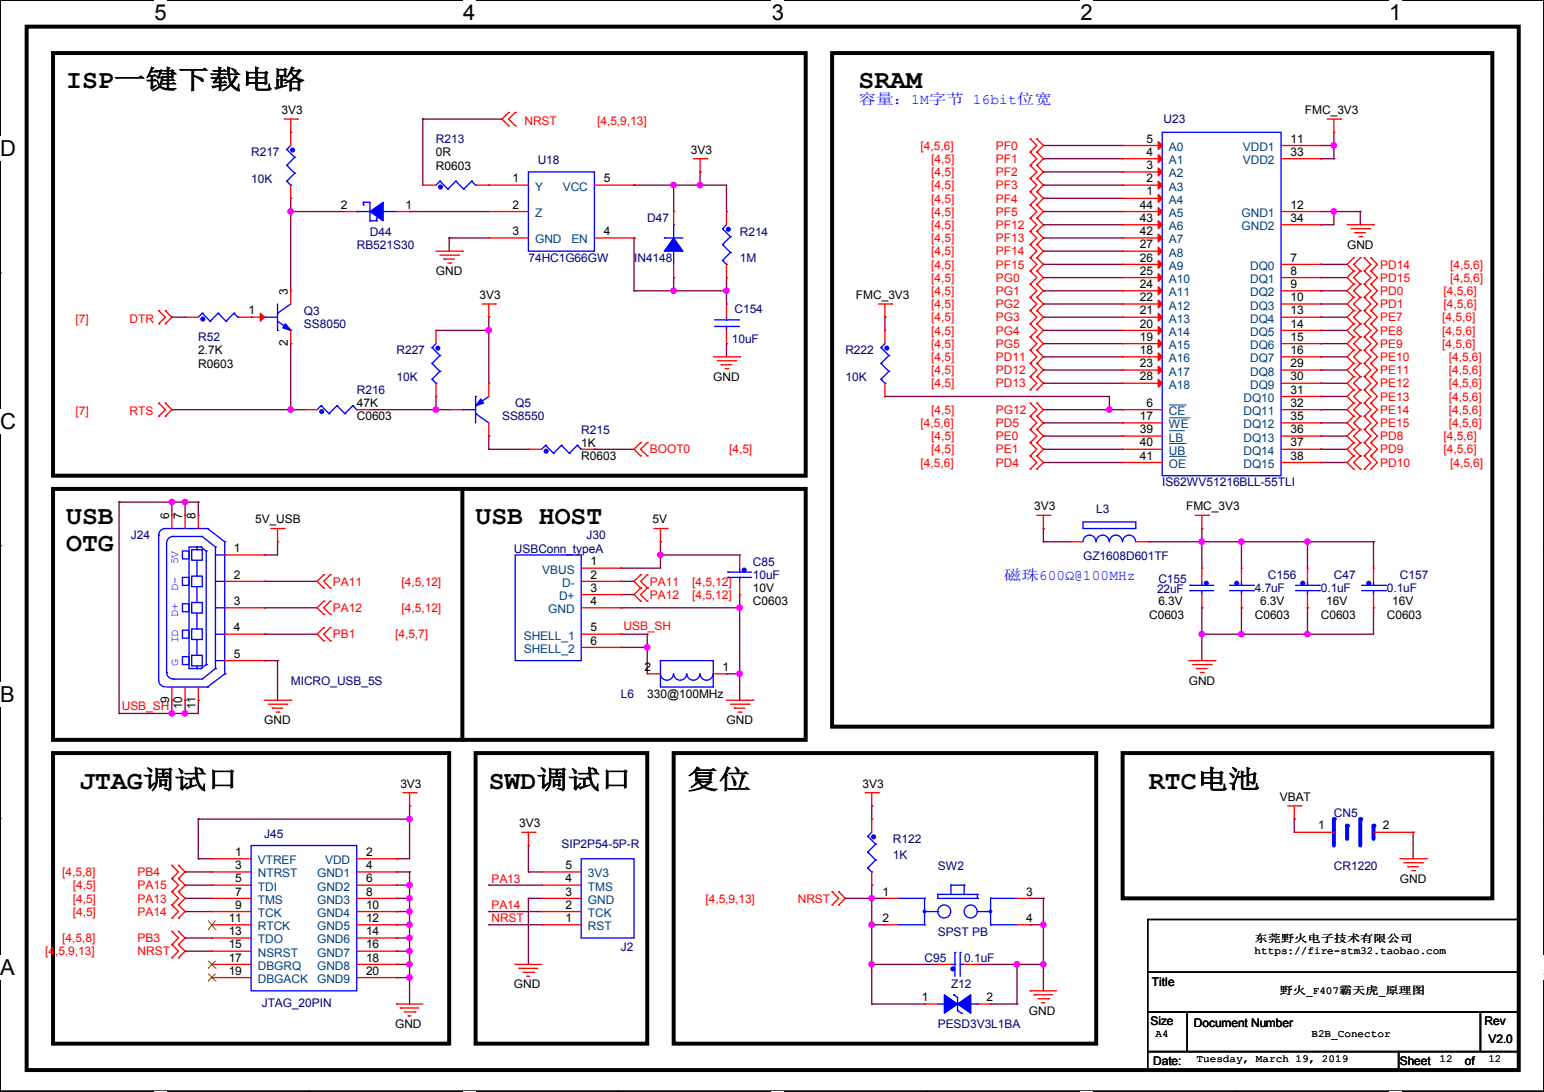
[picture p12: page 12]

东莞野火电子技术有限公司
https://fire-stm32.taobao.com
