Embedfire-stm32f407-batianhu/ebf_stm32f407_batianhu_hardware/hardware/F407_霸天虎V2/尺寸图/F407_霸天虎V2_排针尺寸标注图.pdf

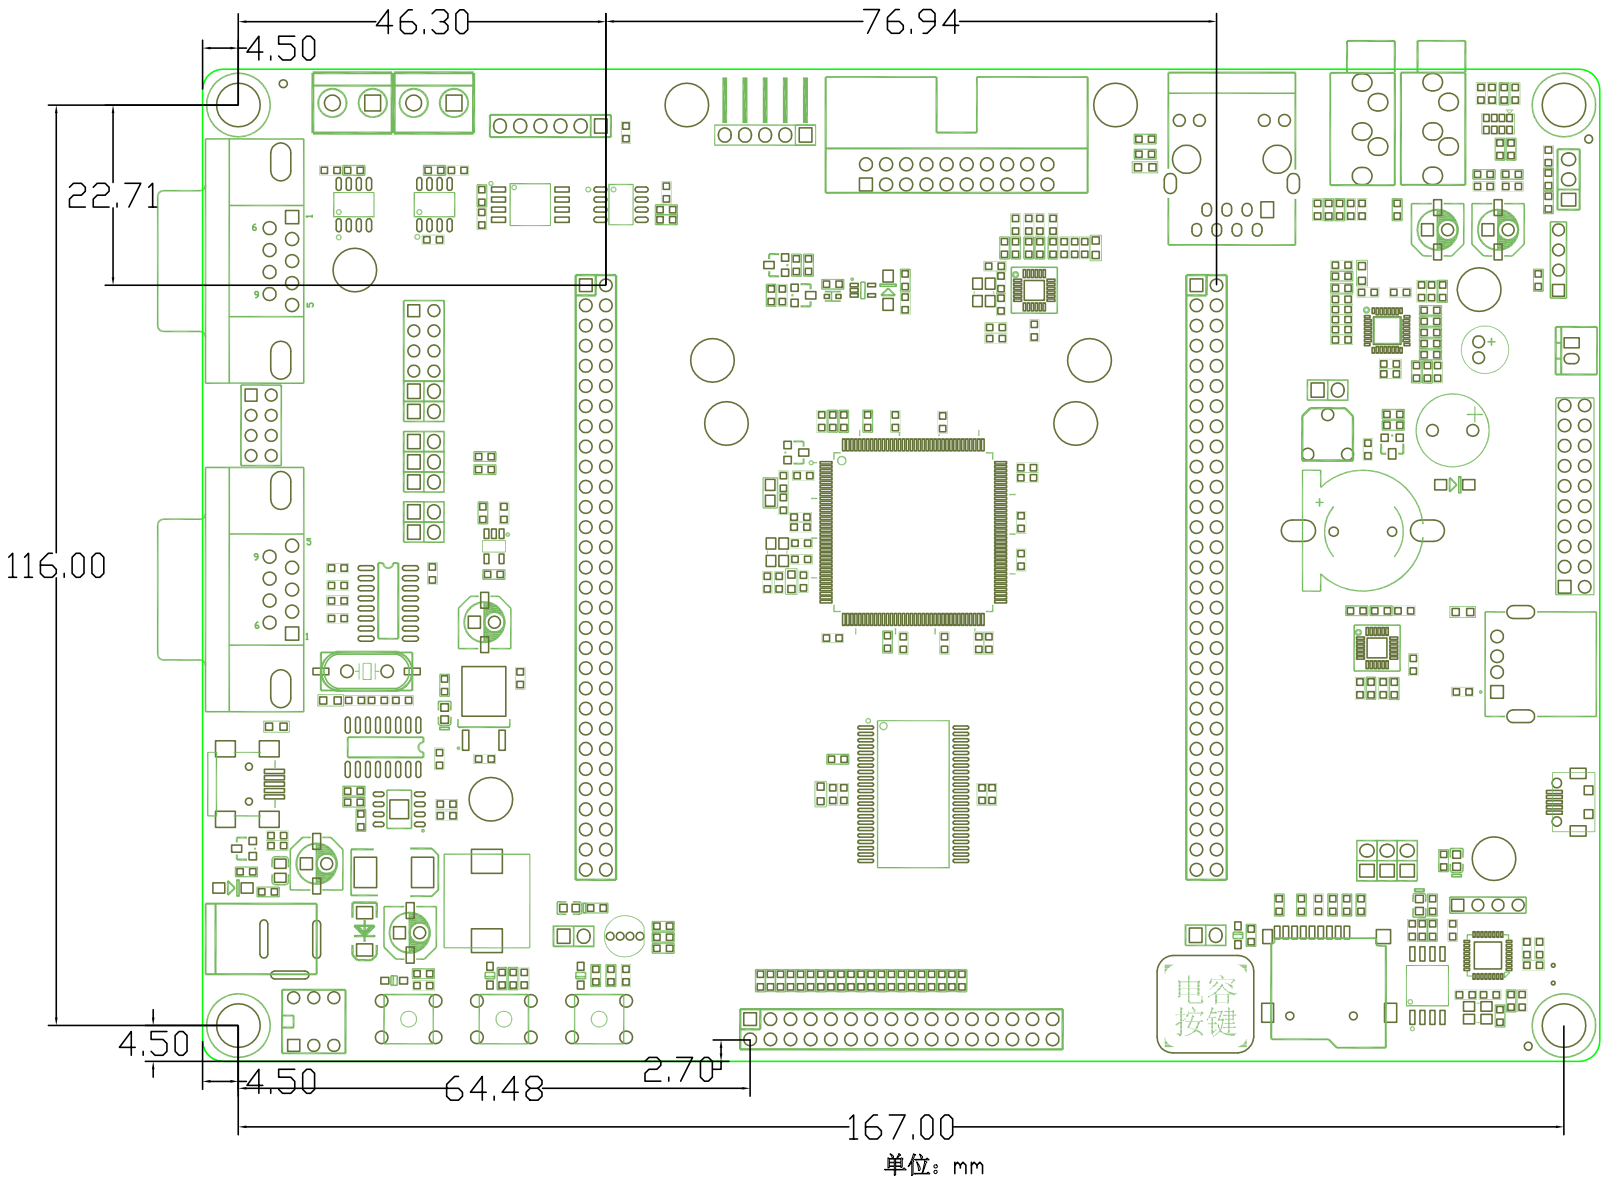
[picture p13: page 1]
