Embedfire-stm32f407-batianhu/ebf_stm32f407_batianhu_hardware/hardware/F407_霸天虎V1/原理图/F407-霸天虎原理图.pdf

# 电源供电

DC IN : 6V~12V | DC DC + LDO 方案

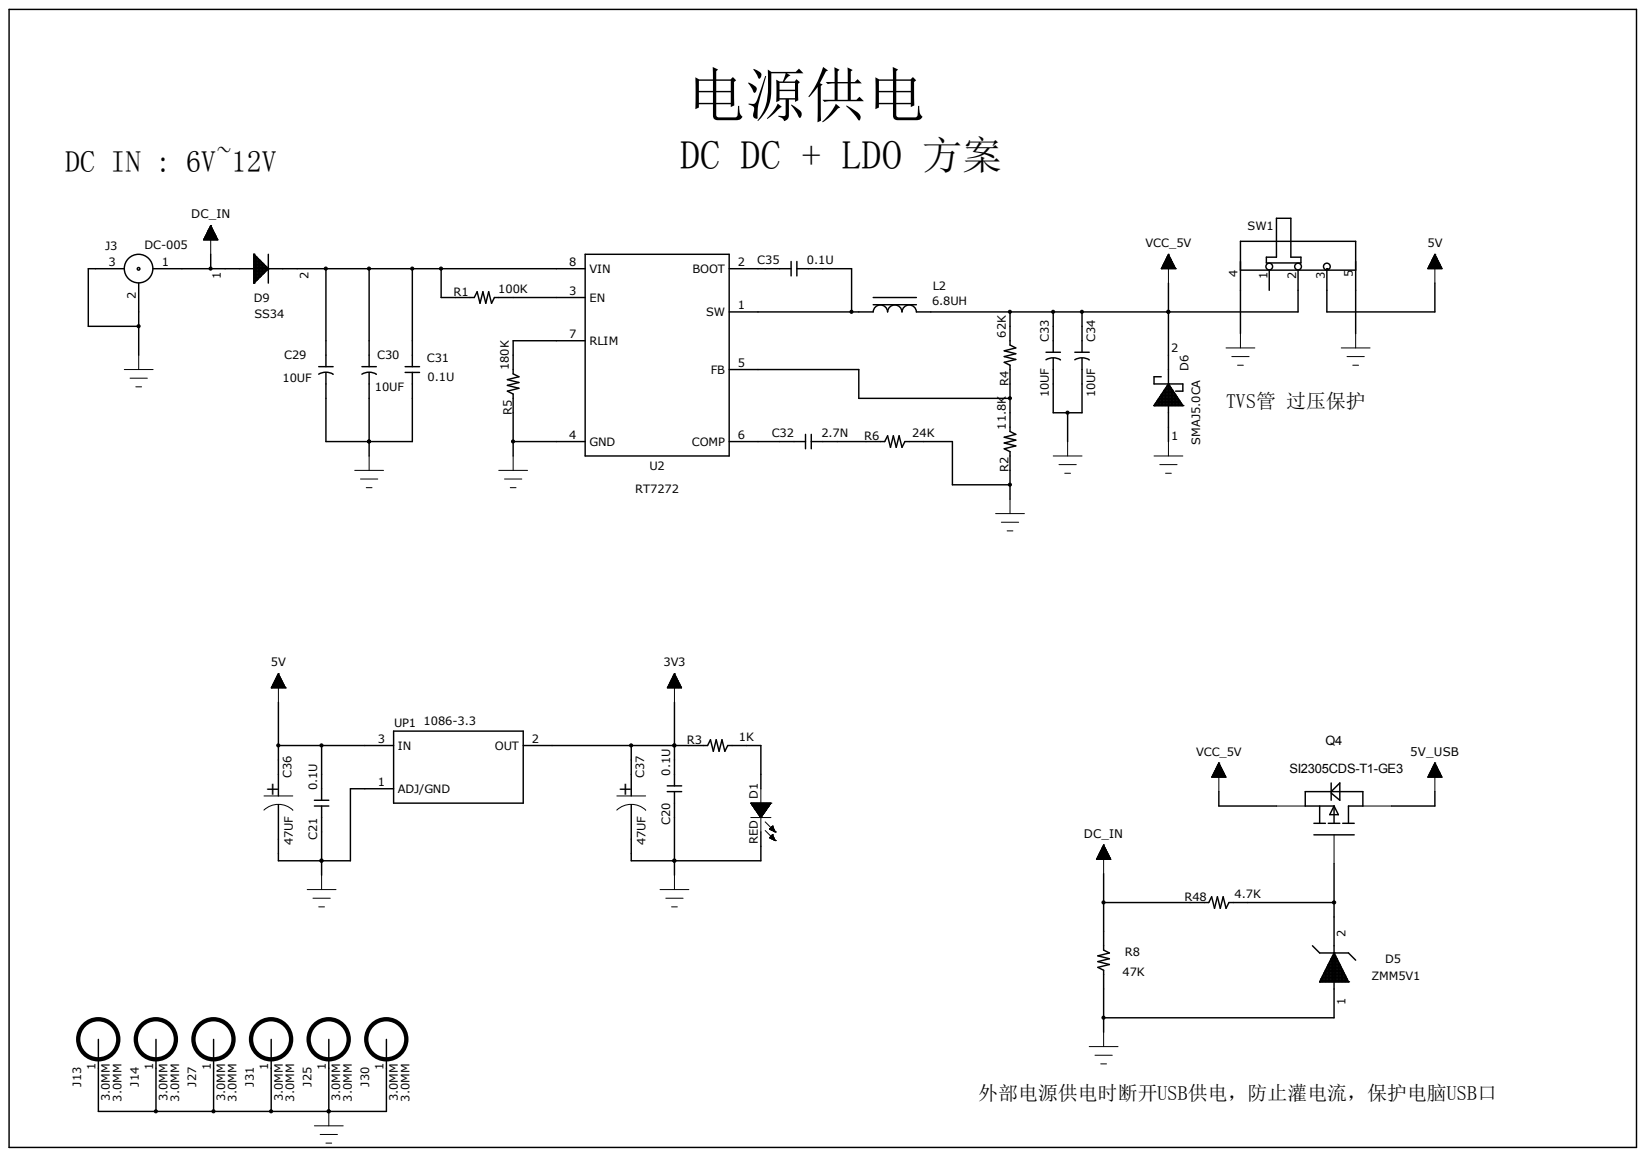
[picture p14: page 1]

# F407 BOOT设置

复位

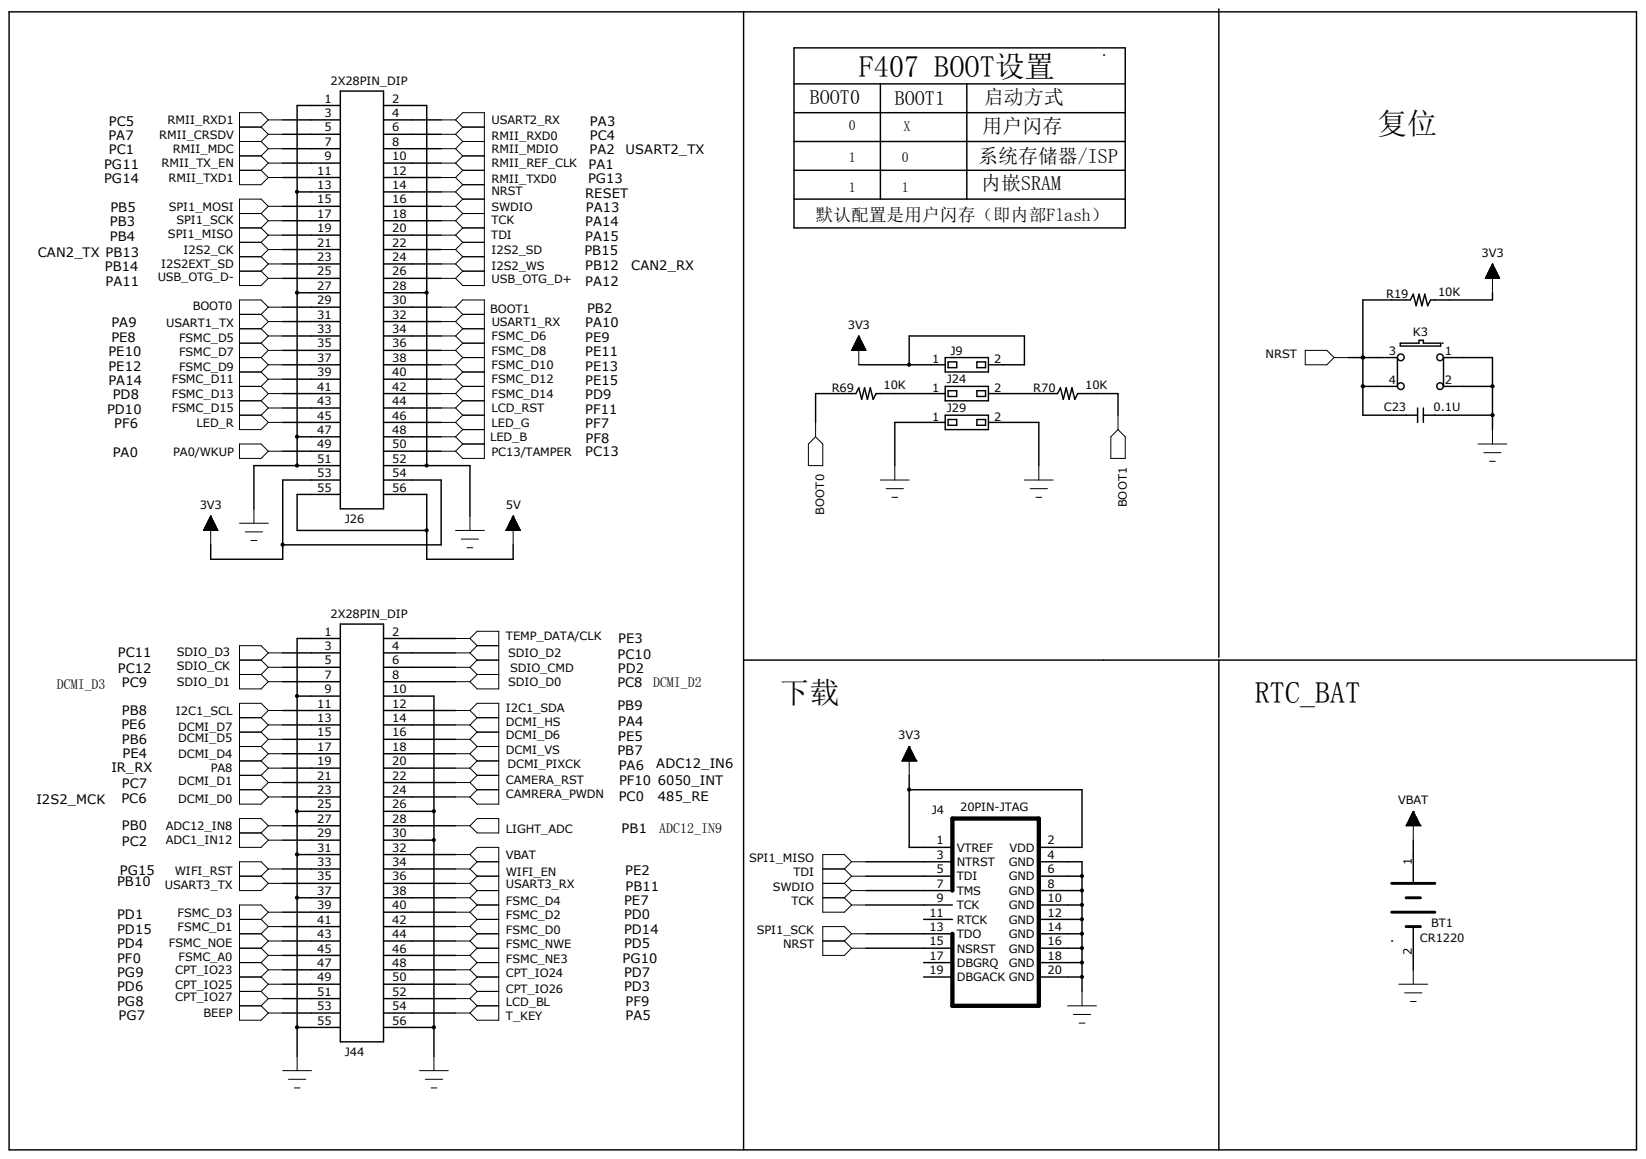
[picture p15: page 2]

BOOT0 | BOOT1 X01 | 启动方式 011 用户闪存

系统存储器/ISP
内嵌SRAM

53 | 54
55 | 56

SDIO接口 | I2C接口 | SPI/I2S接口
PC8 | PD2

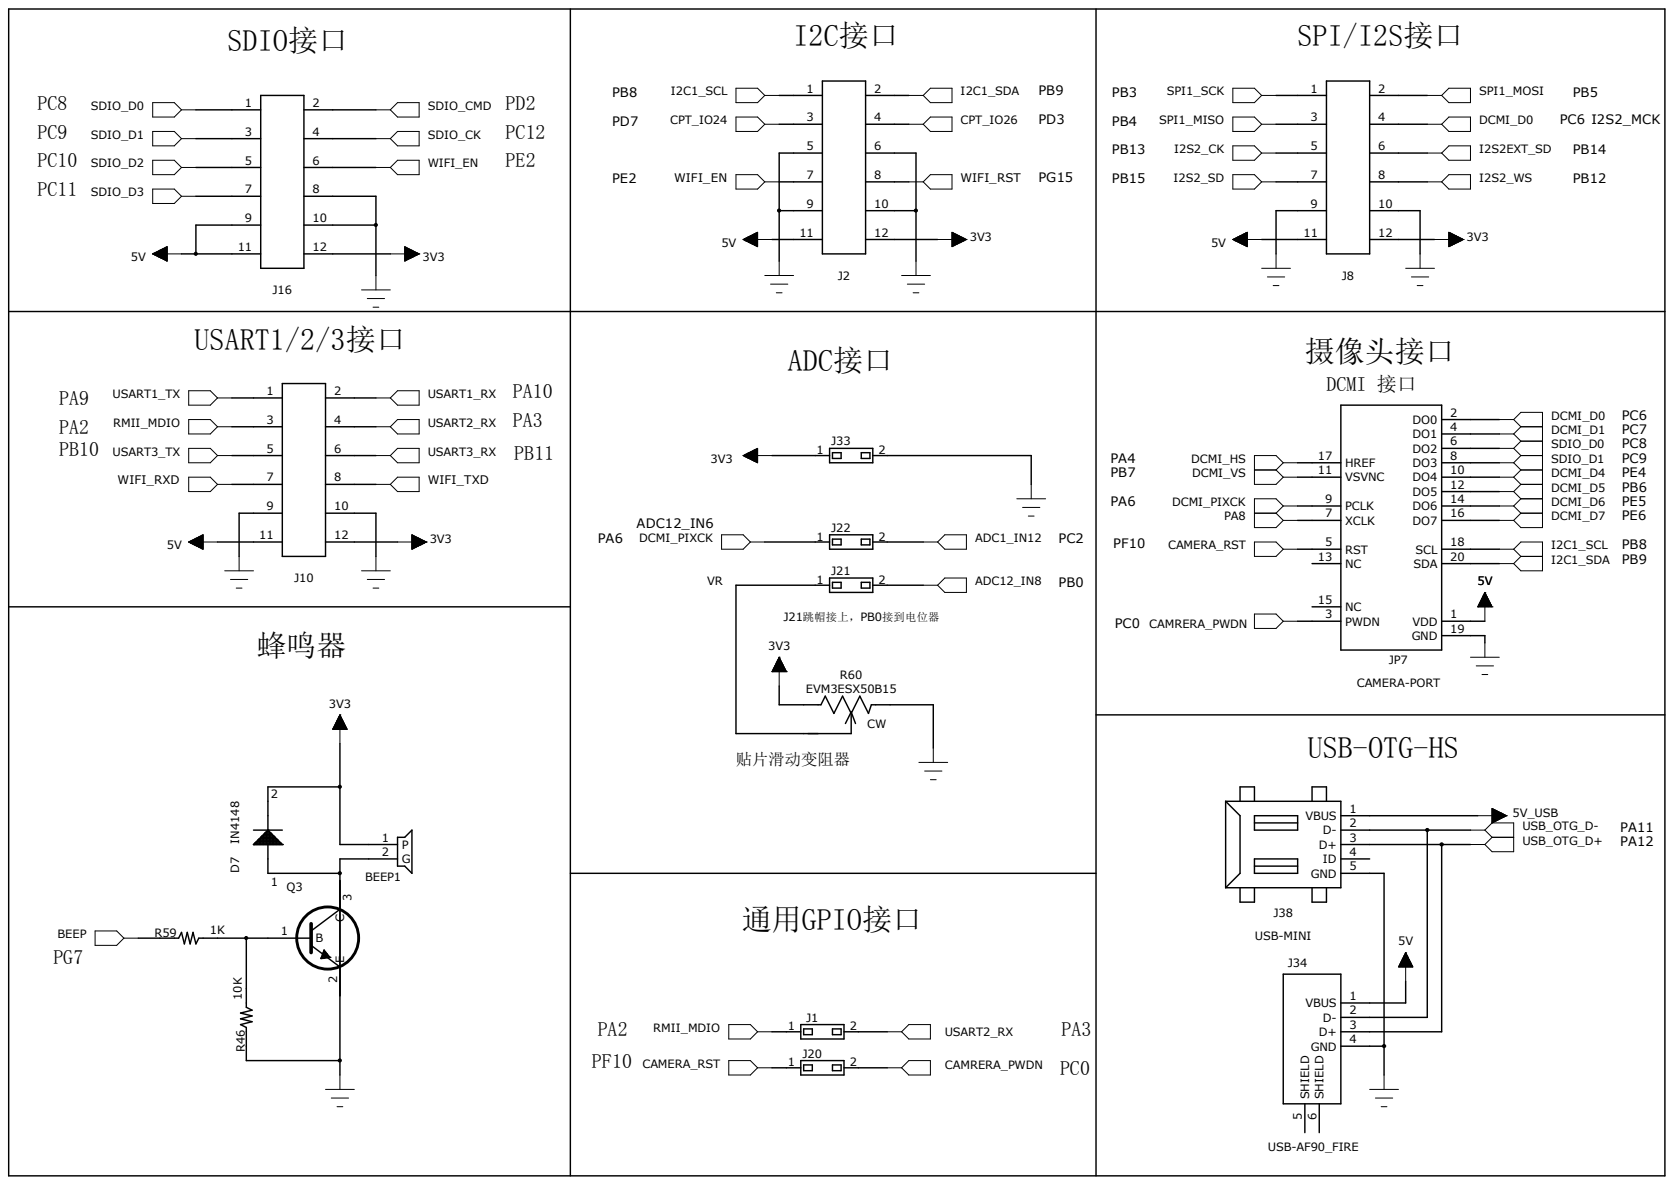
[picture p16: page 3]

# USB转串口

# ISP一键下载电路

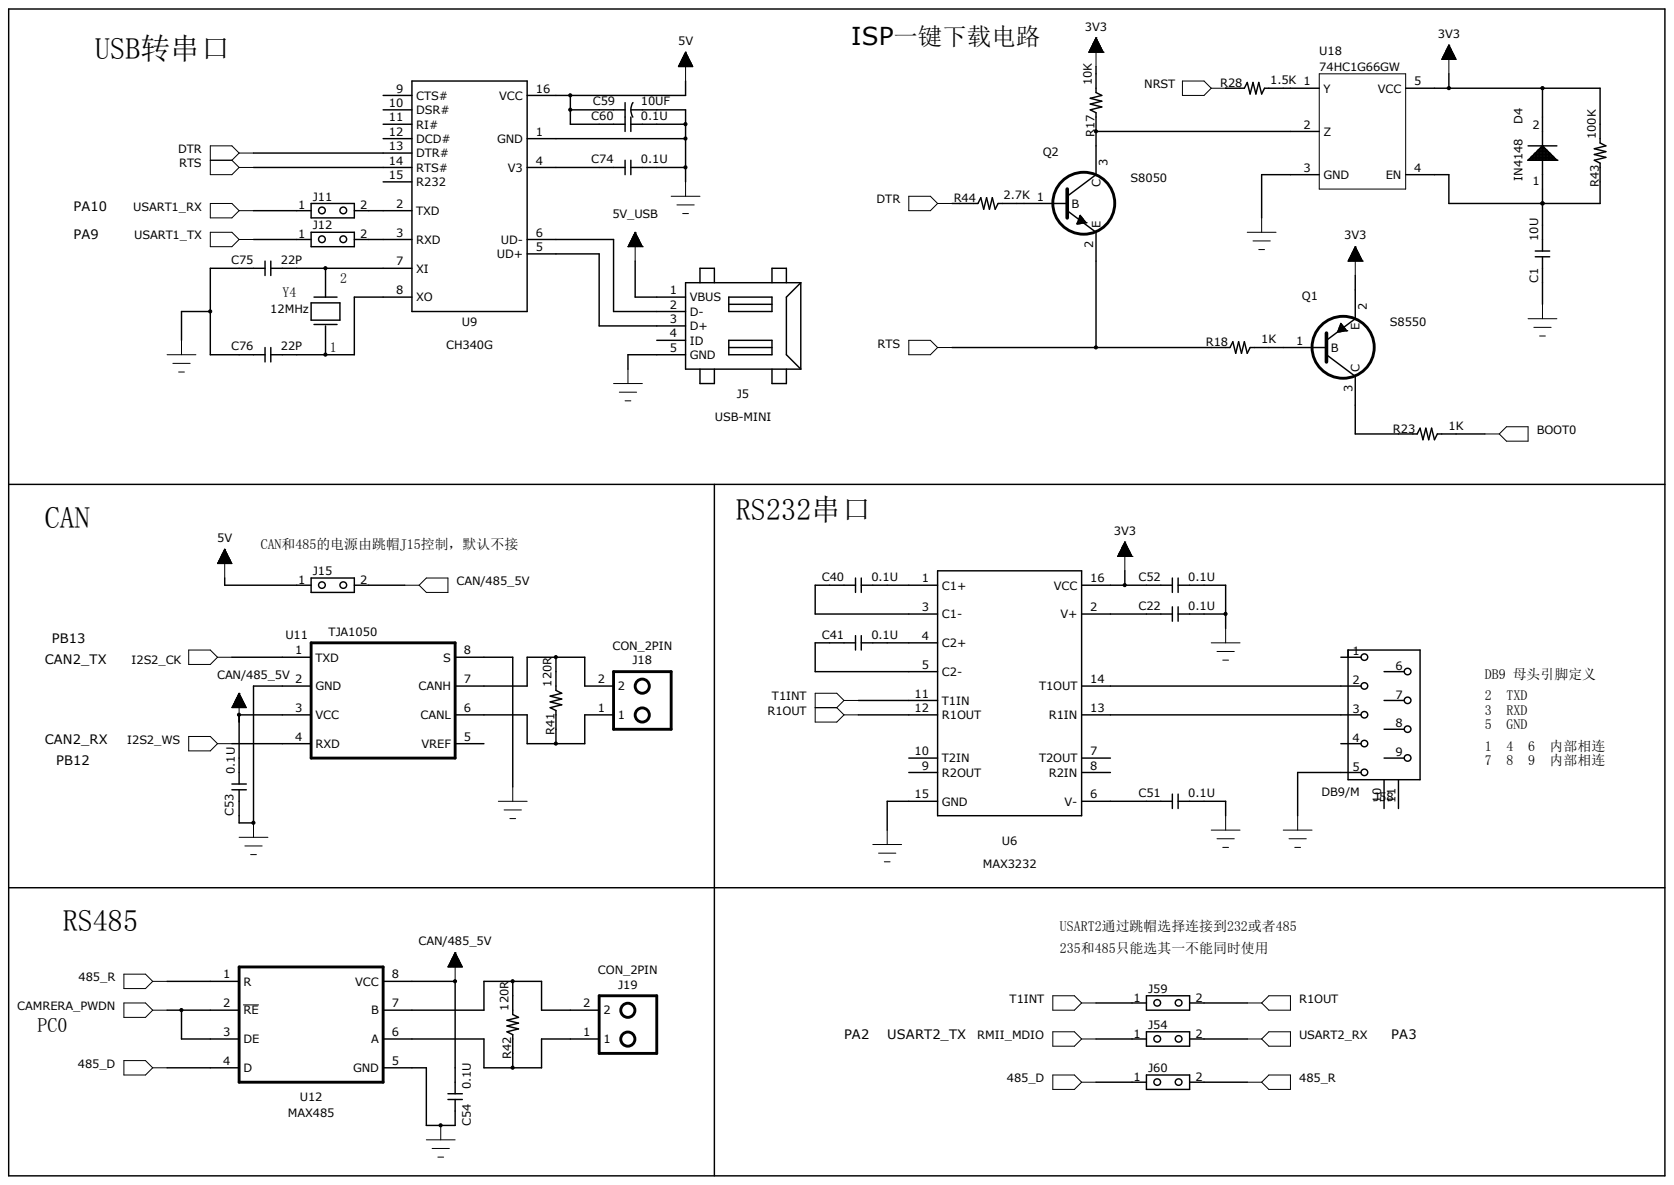
[picture p17: page 4]

1 GND

# 4.5寸液晶 FSMC接口

PE7

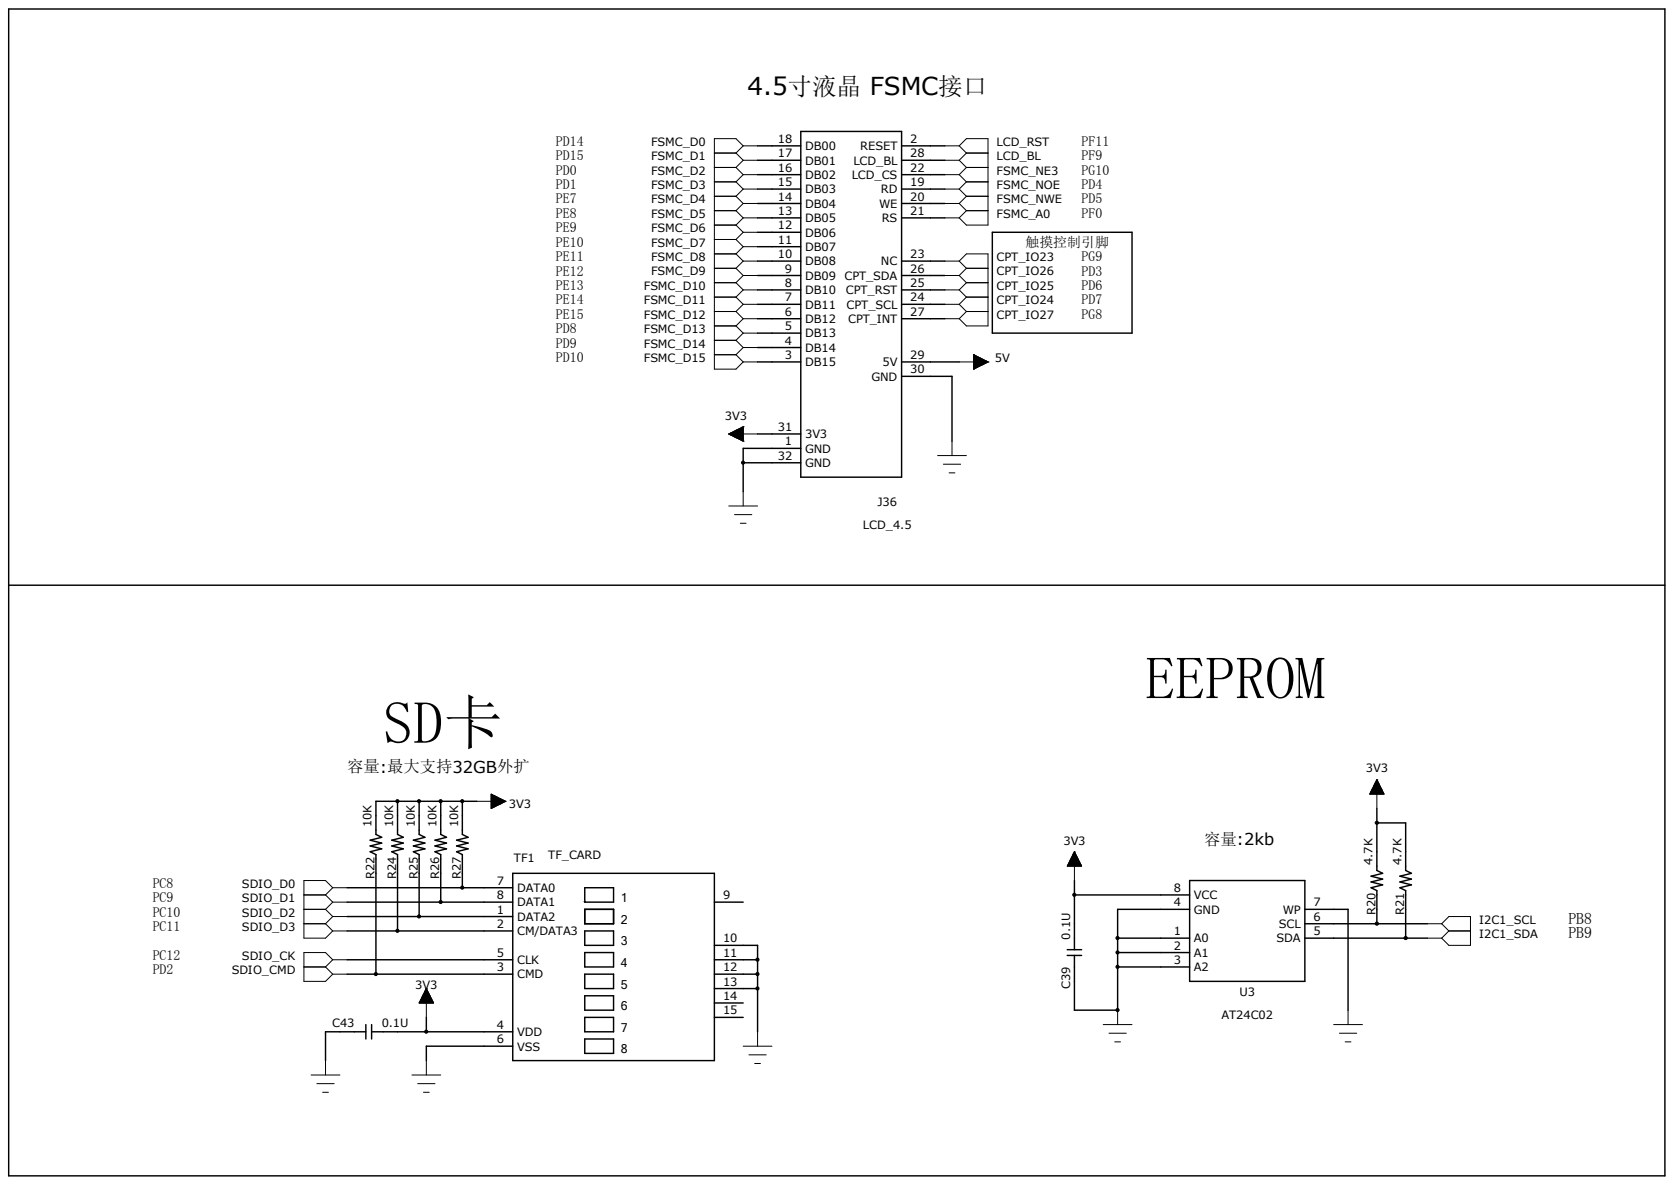
[picture p18: page 5]

# 网络接口

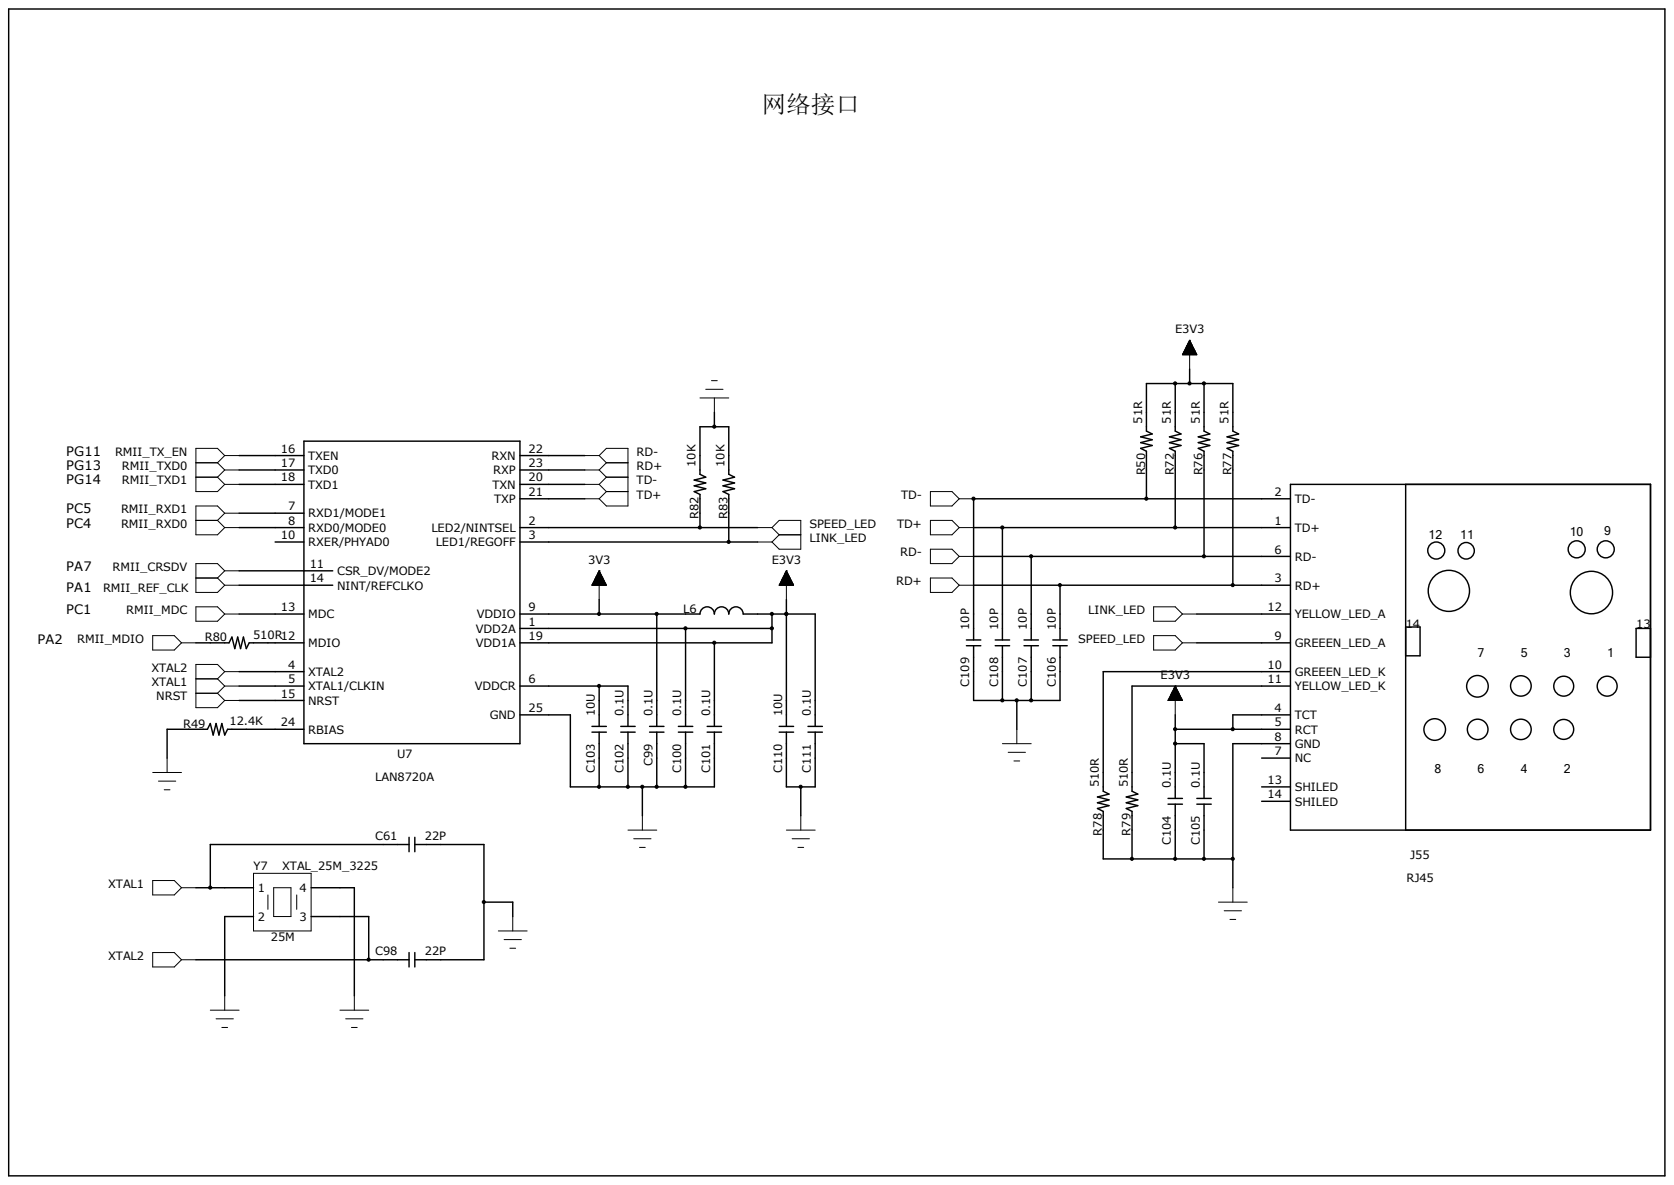
[picture p19: page 6]

# LED

# KEY

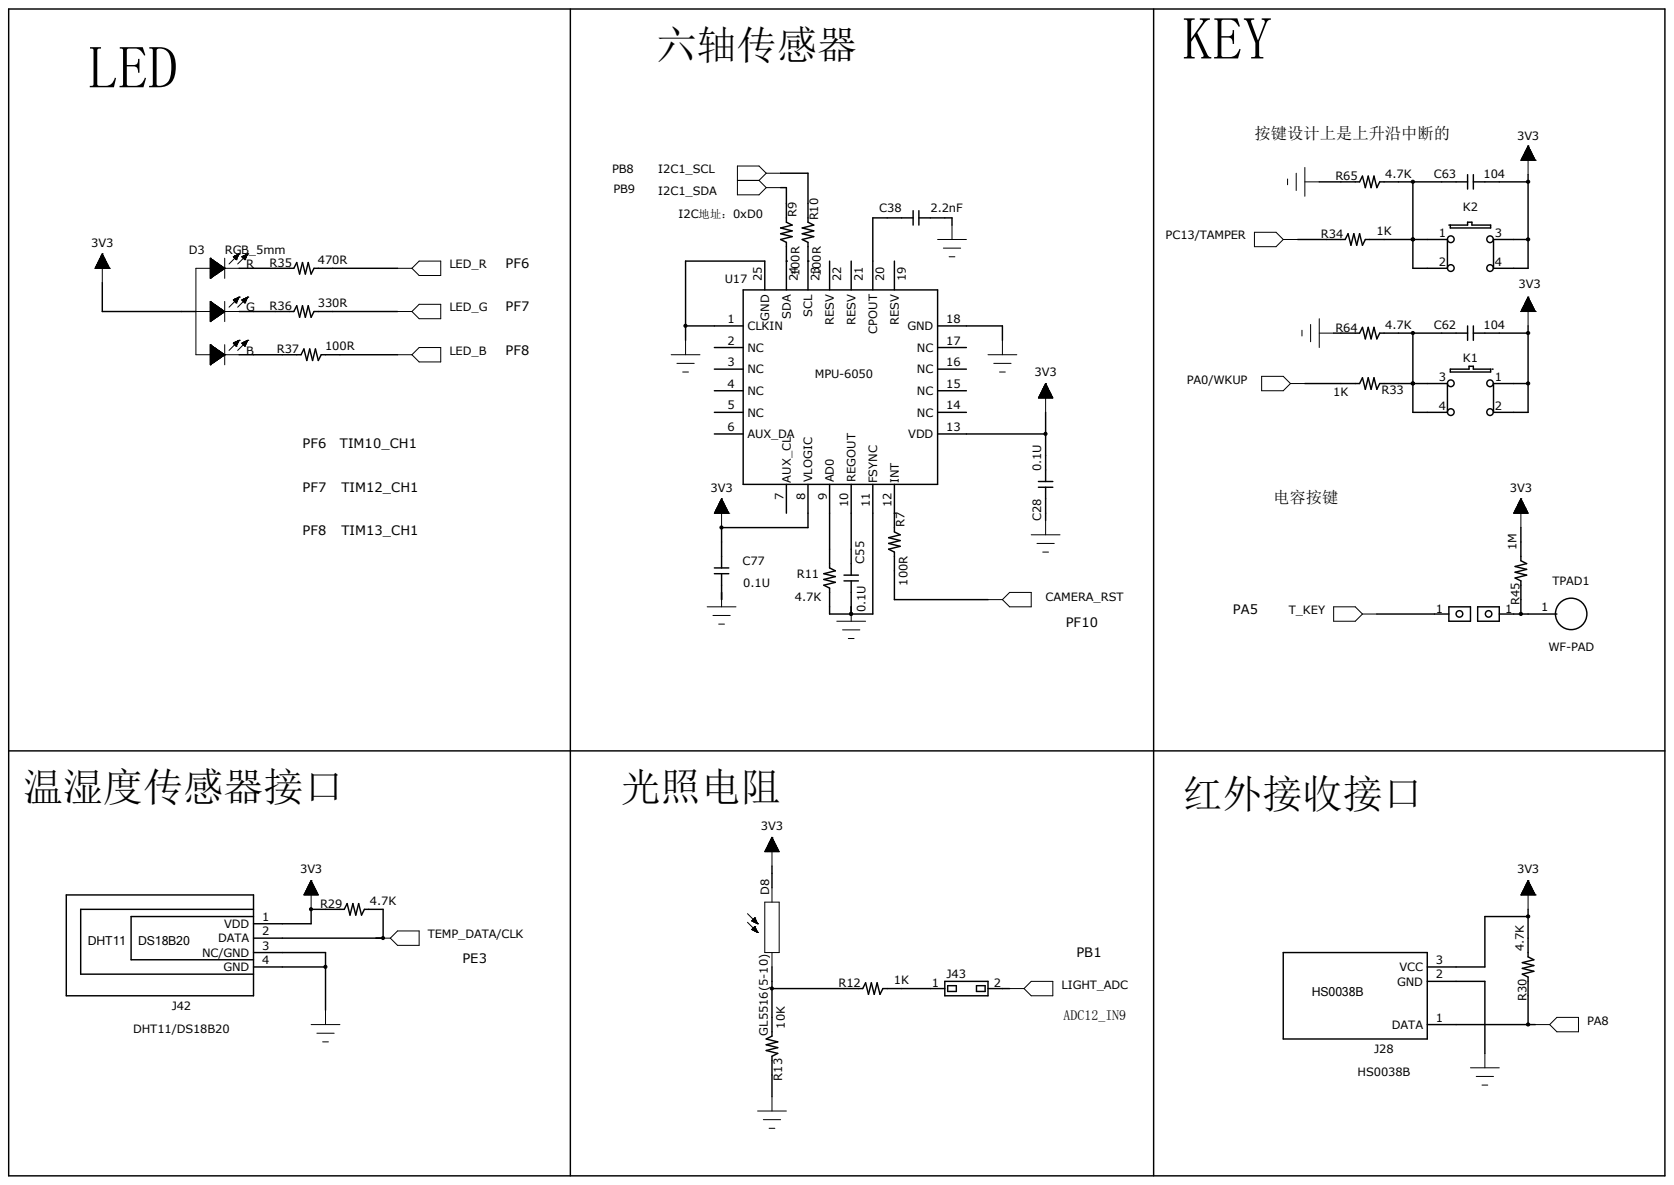
[picture p20: page 7]

# I2S音频DAC

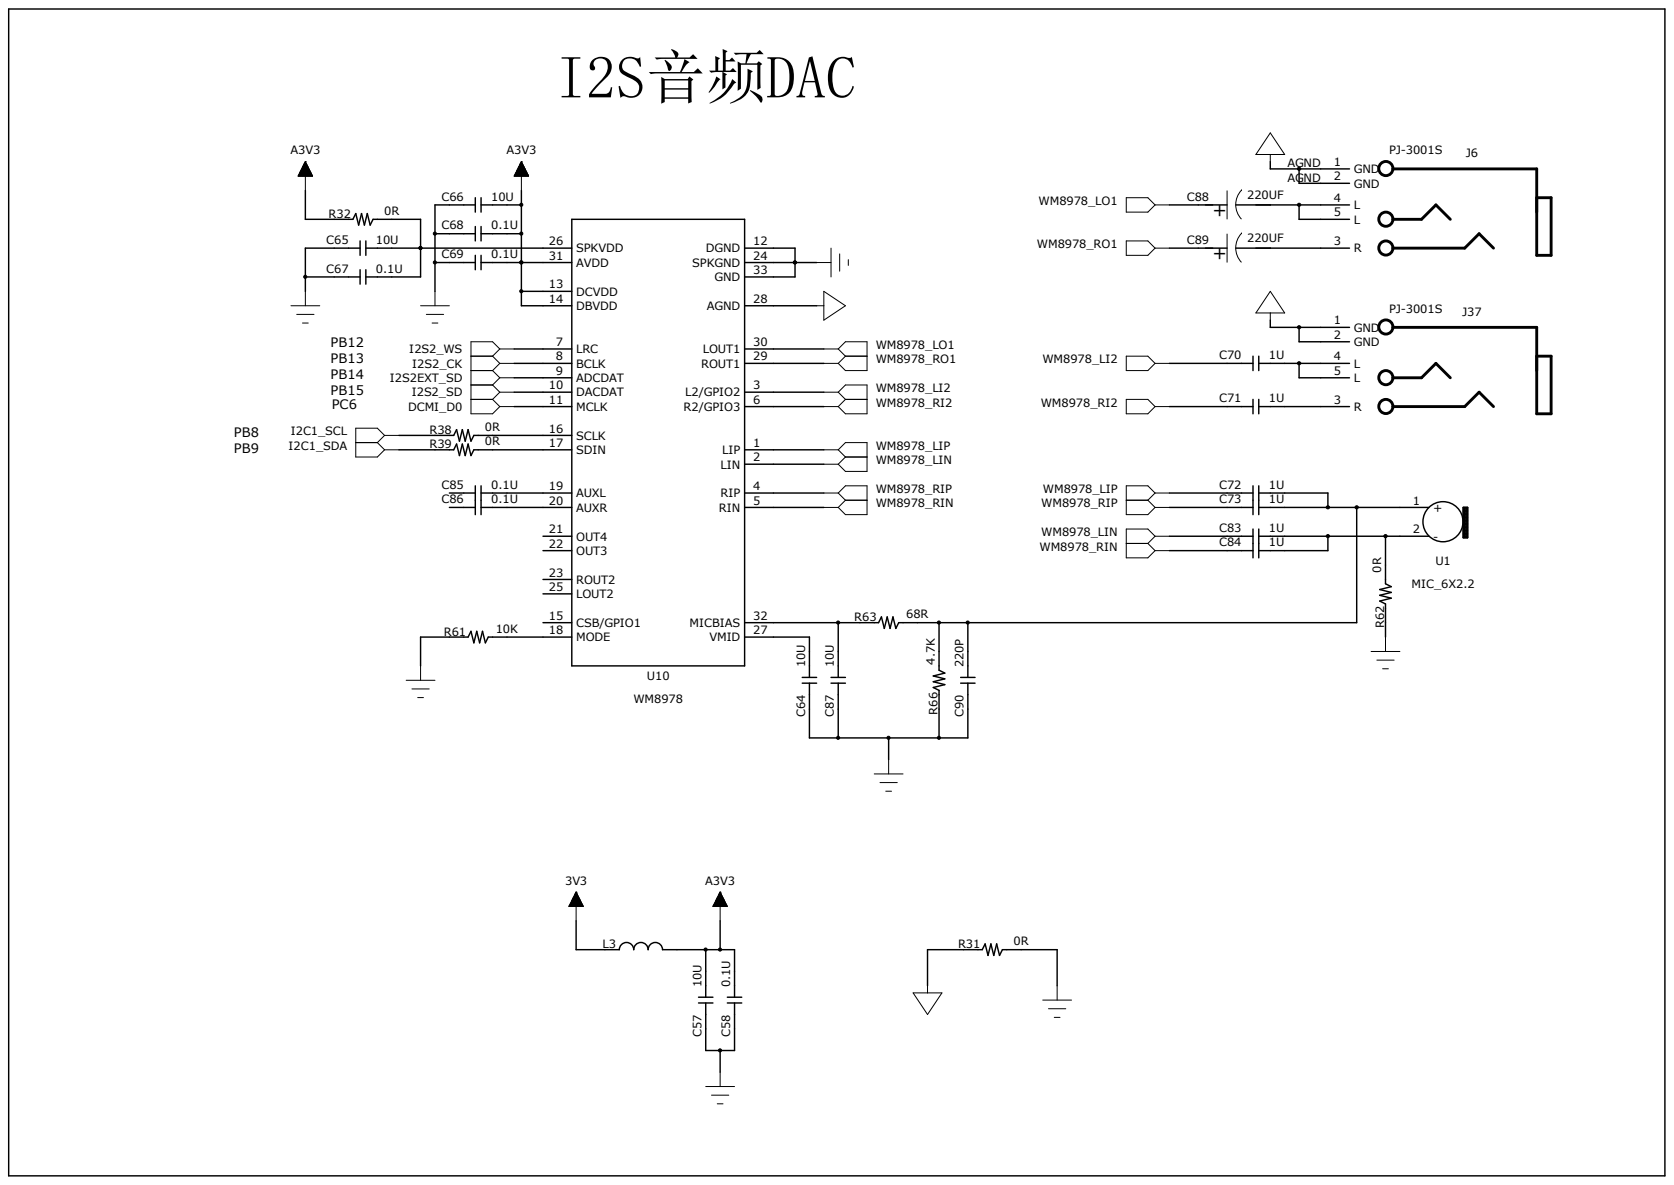
[picture p21: page 8]

# WIFI模块

Y5

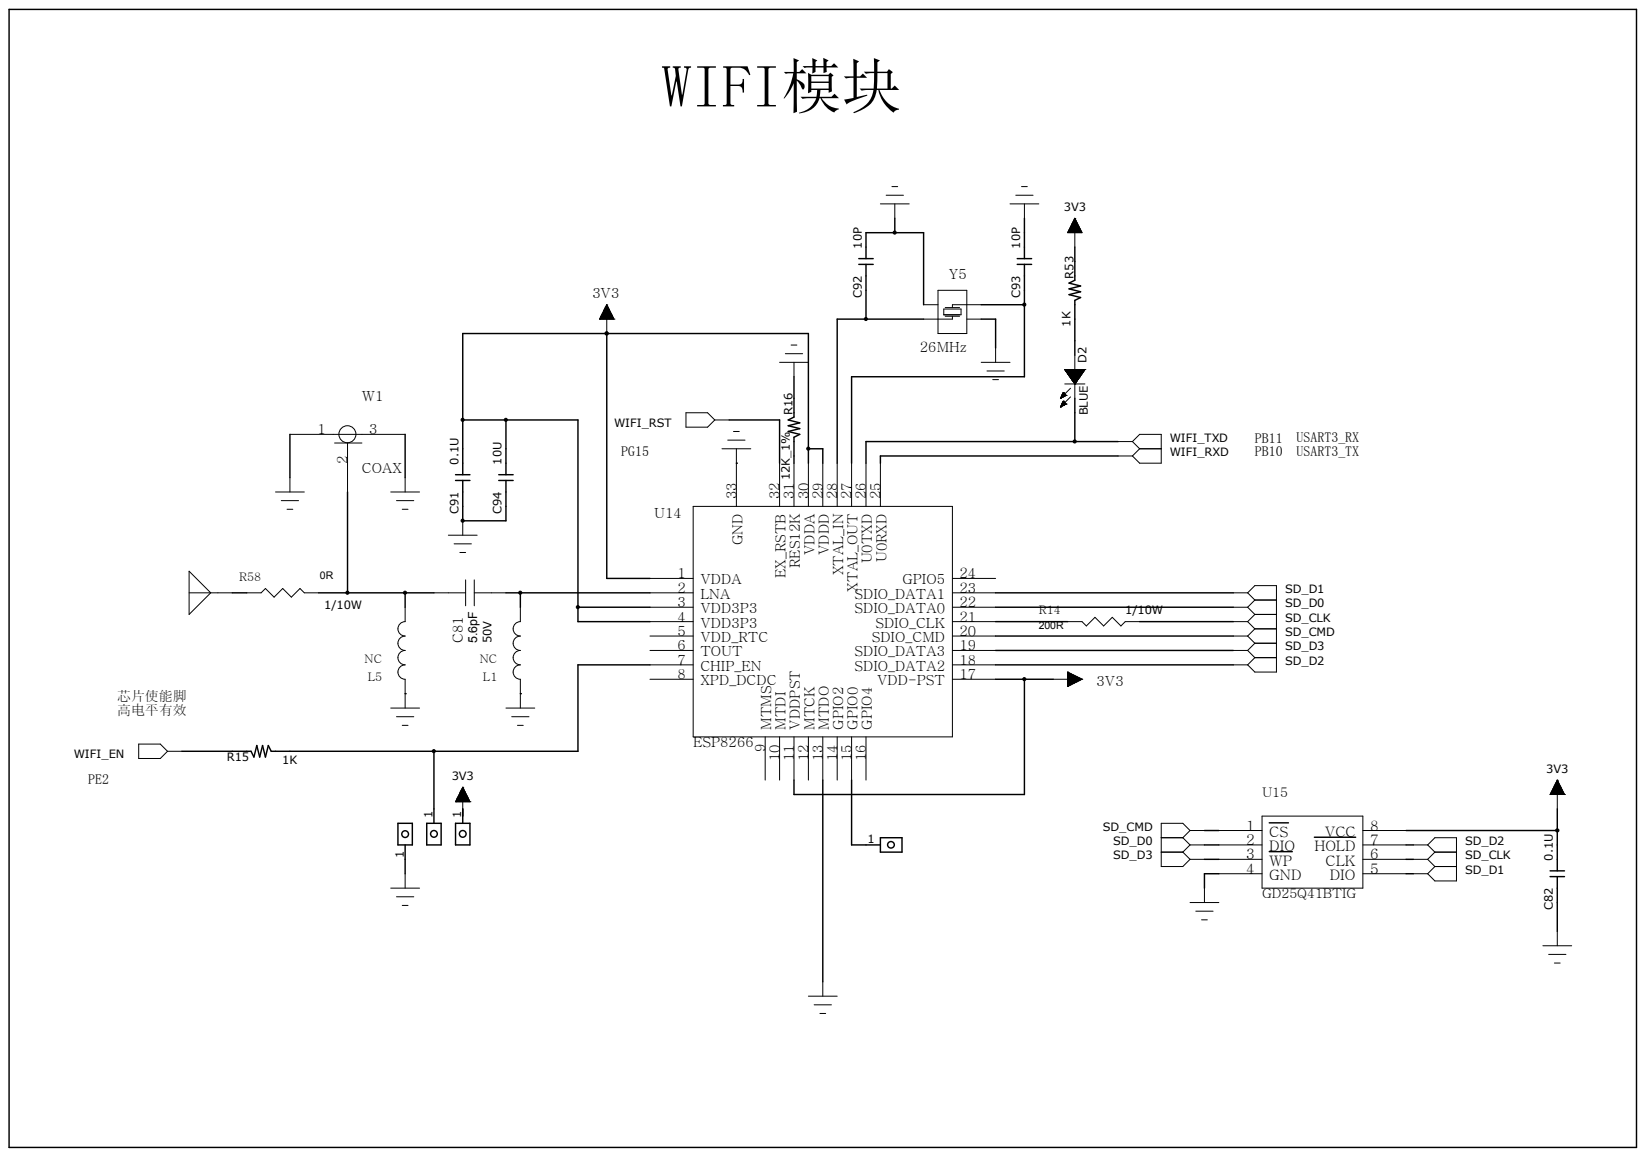
[picture p22: page 9]
