Embedfire-stm32f407-batianhu/ebf_stm32f407_batianhu_hardware/hardware/F407_霸天虎V1/原理图/F407-霸天虎核心板V1_170119_01.pdf

排针

# 液晶接口-FSMC模式

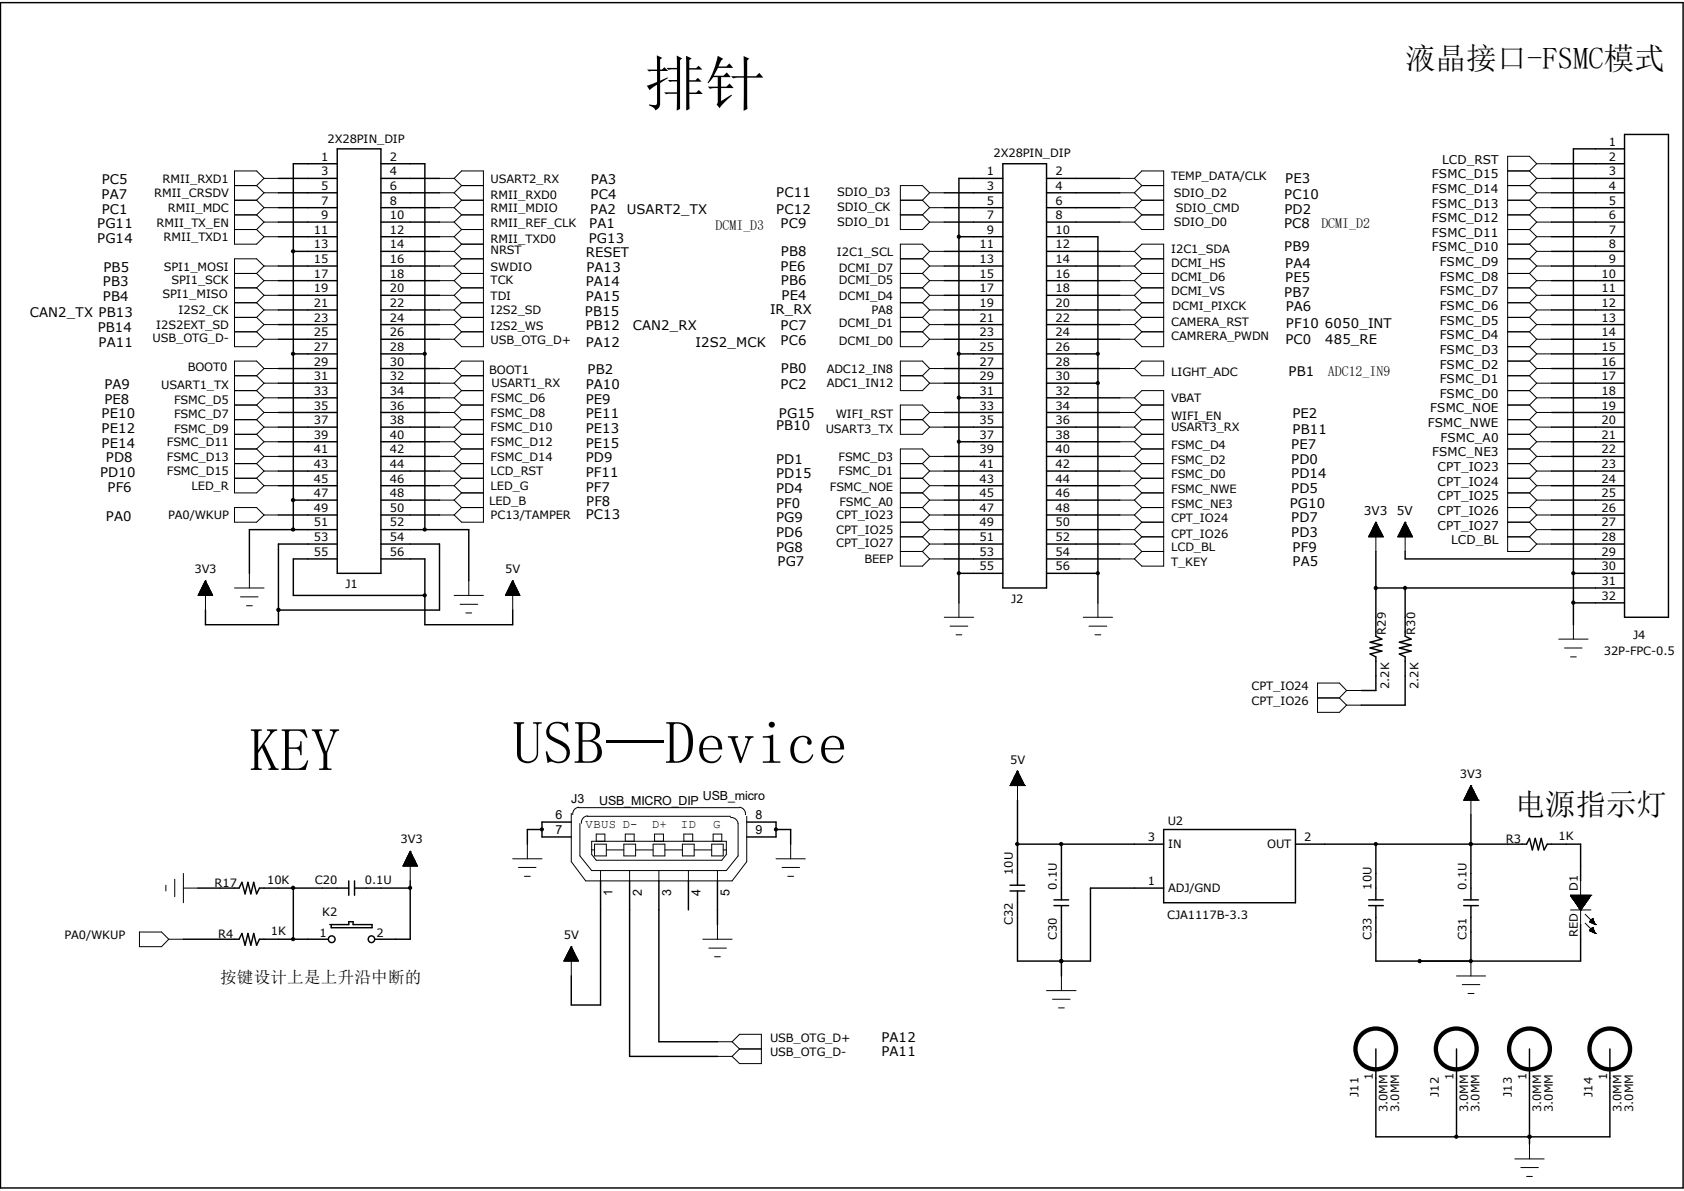
[picture p23: page 1]

53 | 54
55 | 56

### TOUCH_KEY

### USART2_TXD

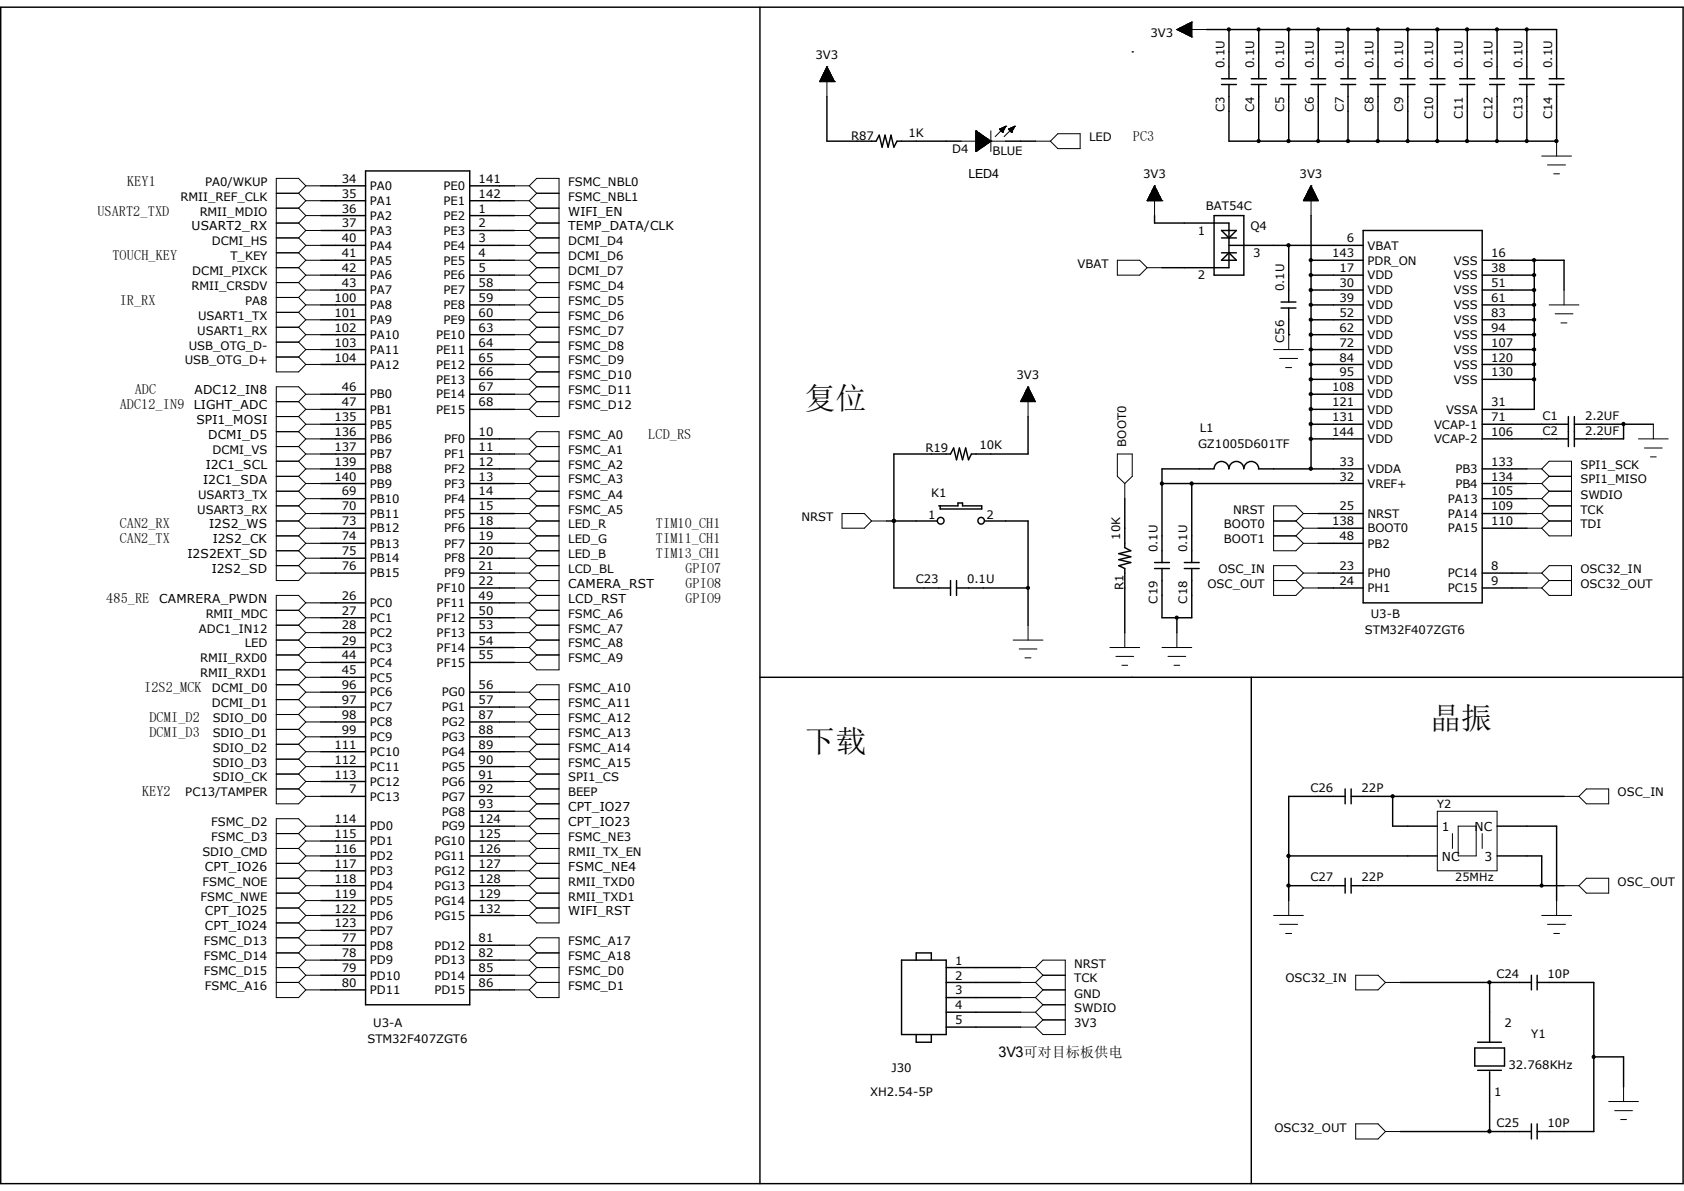
[picture p24: page 2]

# 串行FLASH 容量:16MB

# SRAM 容量:1MB

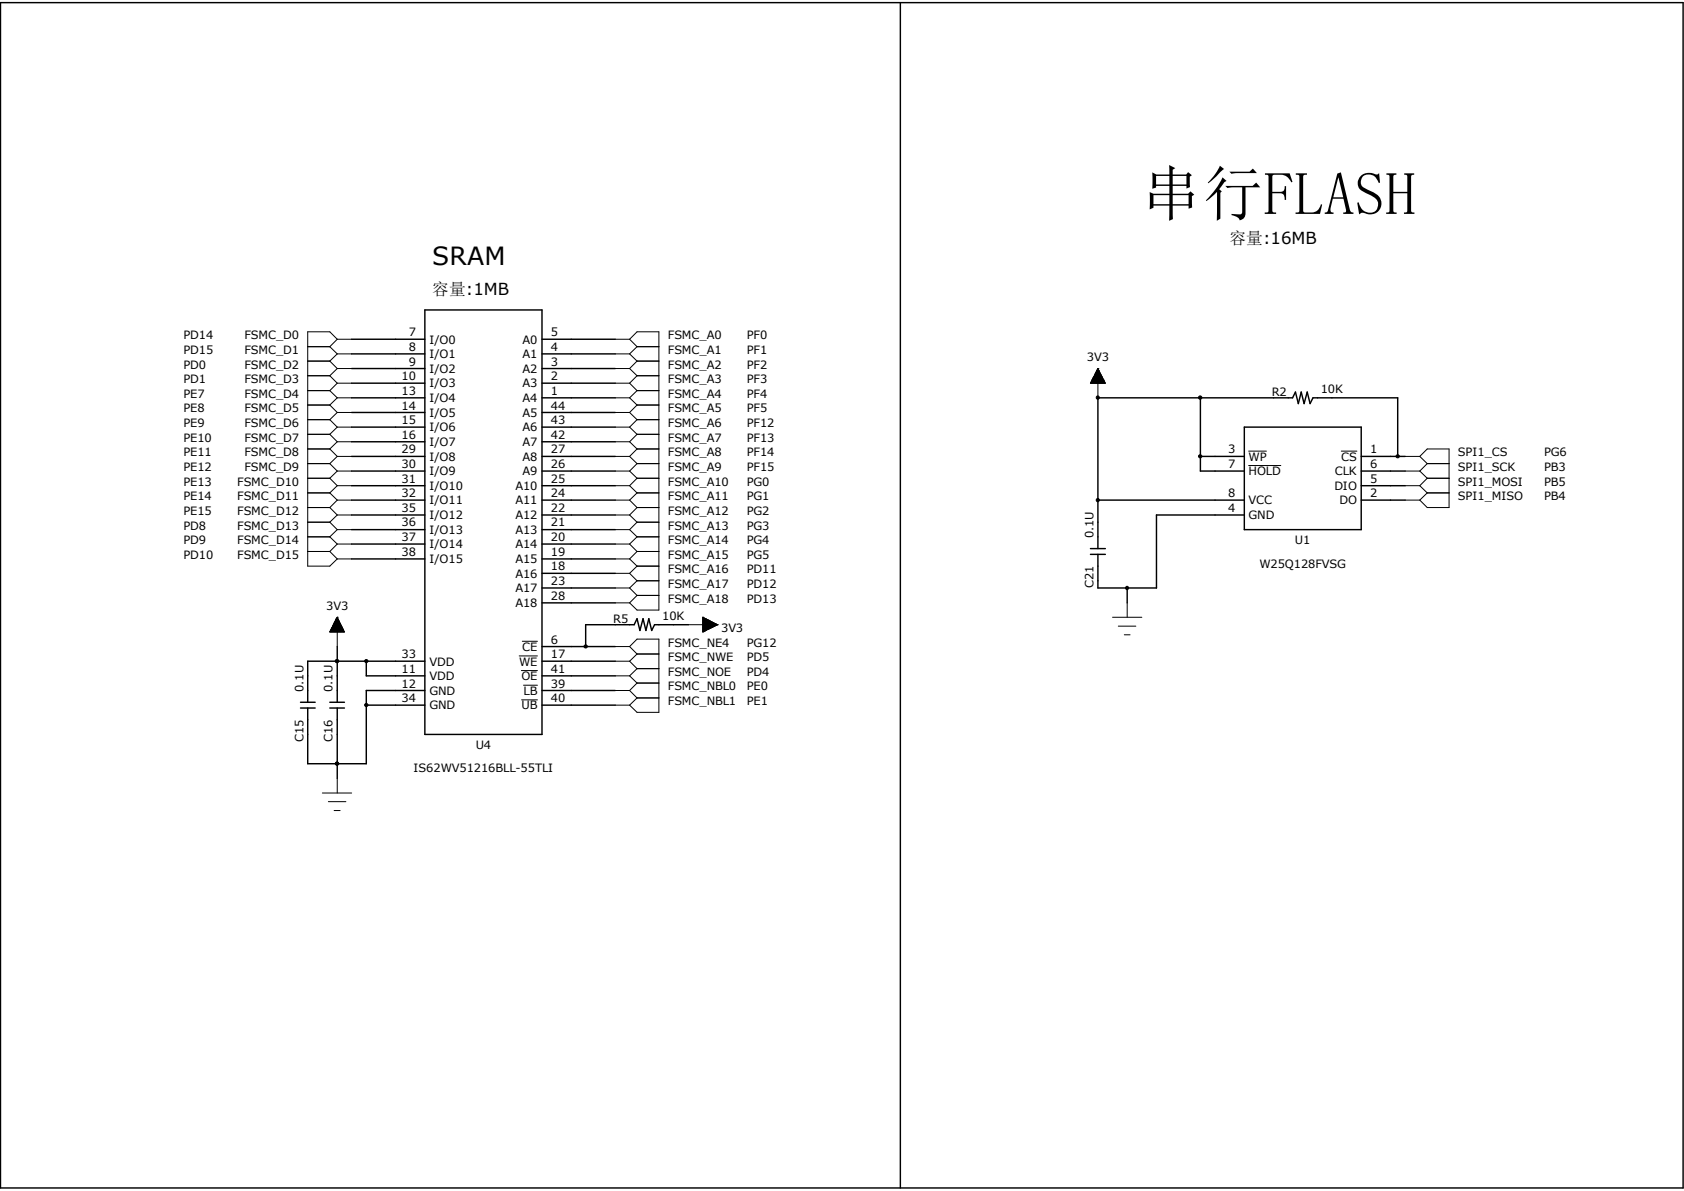
[picture p25: page 3]
GND; 5 DIO; 6 CLK; HOLD 8; VCC; W25Q128FVSG; VDD 12; VDD; IS62WV51216BLL-55TLI; SPI1_CS SPI1_SCK SPI1_MOSI SPI1_MISO; FSMC_NE4 FSMC_NWE FSMC_NOE FSMC_NBL0 FSMC_NBL1; FSMC_A0 FSMC_A1 FSMC_A2 FSMC_A3 FSMC_A4 FSMC_A5 FSMC_A6; FSMC_A9; FSMC_A7 FSMC_A8; FSMC_A10; FSMC_A15; FSMC_A11 FSMC_A12 FSMC_A13 FSMC_A14; FSMC_A16 FSMC_A17 FSMC_A18; FSMC_D0 FSMC_D1 FSMC_D2 FSMC_D3 FSMC_D4 FSMC_D5 FSMC_D6 FSMC_D7 FSMC_D8 FSMC_D9 FSMC_D10 FSMC_D11 FSMC_D12 FSMC_D13 FSMC_D14 FSMC_D15
