Embedfire-stm32f407-batianhu/ebf_stm32f407_batianhu_hardware/hardware/F407_霸天虎V1/尺寸图/F407_CORE_V1尺寸图.pdf

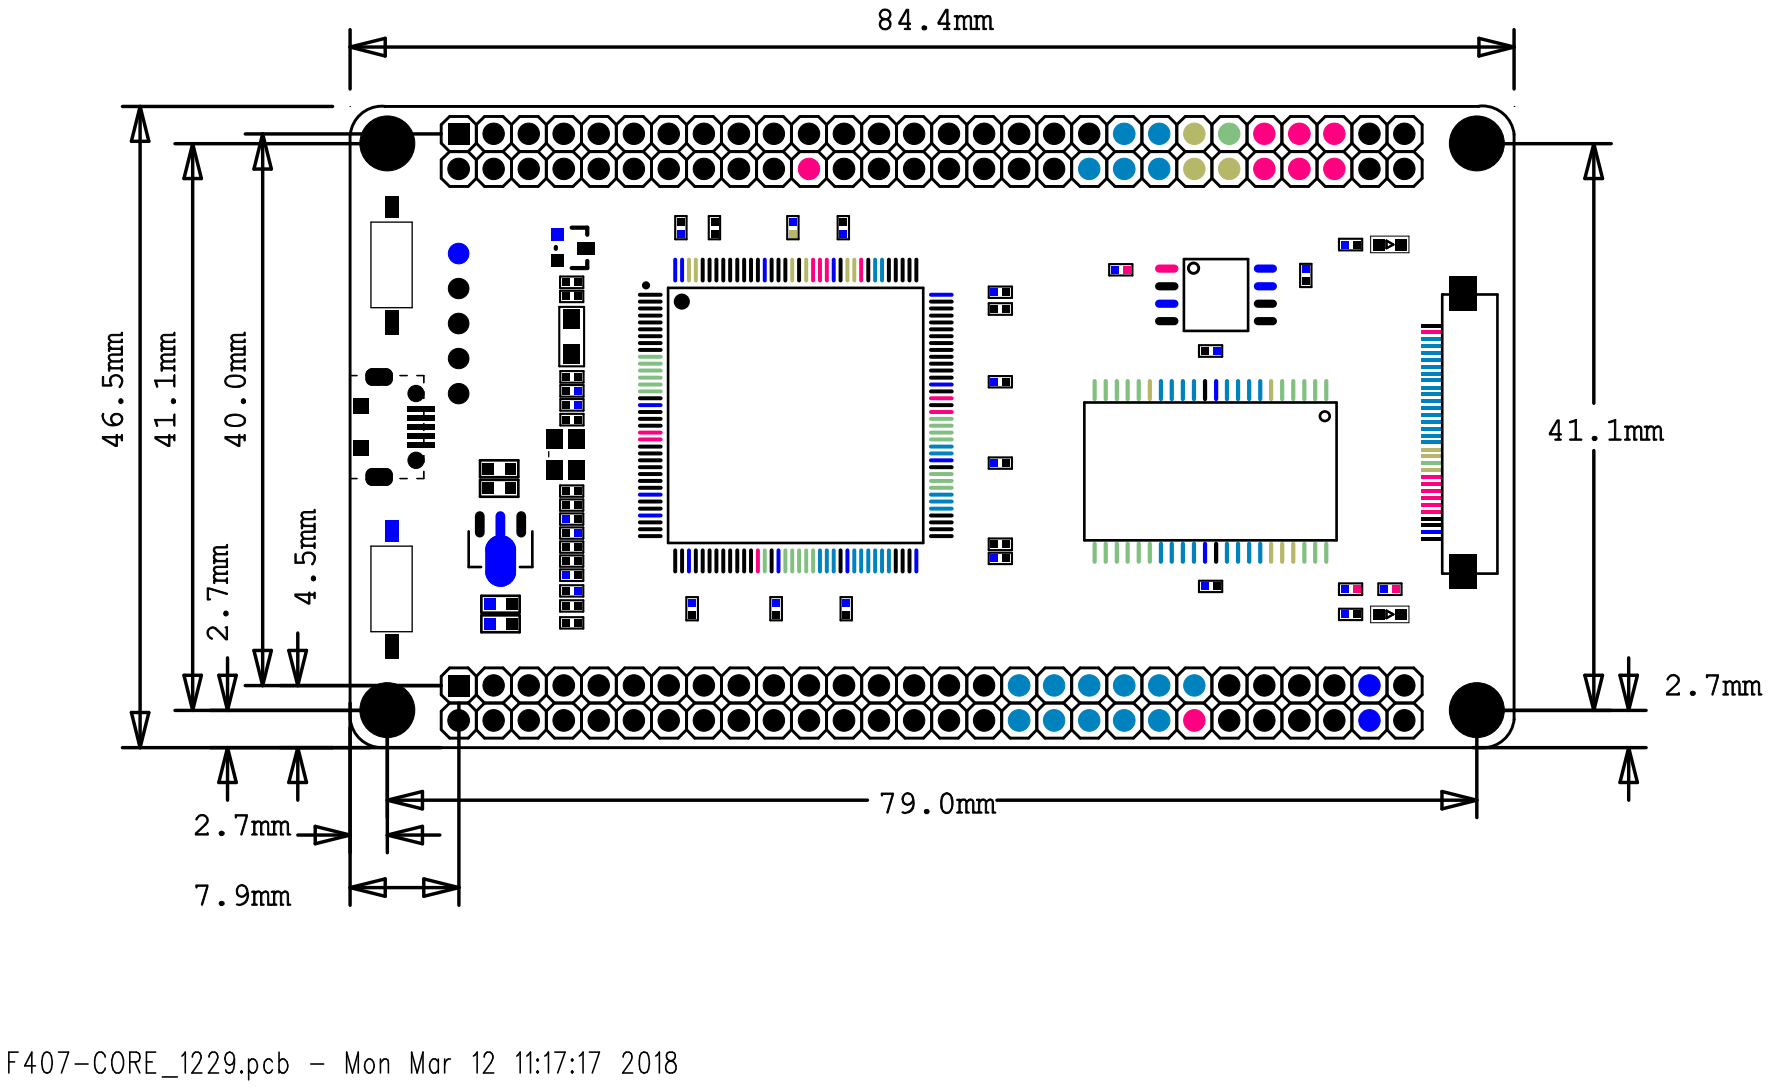
[picture p26: page 1]
