Embedfire-stm32f407-batianhu/ebf_stm32f407_batianhu_hardware/(list of files, drawings)

Other design files:
hardware/F407_霸天虎V1/封装库/F407底板+核心板封装库/F407_CORE封装库/PCB/AD/F407-CORE.PcbLib
hardware/F407_霸天虎V1/封装库/F407底板+核心板封装库/F407_CORE封装库/SCH/AD/F407_CORE.SCHLIB
hardware/F407_霸天虎V1/封装库/F407底板+核心板封装库/F407_MB封装库/PCB/AD/F407_MB.PcbLib
hardware/F407_霸天虎V1/封装库/F407底板+核心板封装库/F407_MB封装库/SCH/AD/F407_MB.SCHLIB
hardware/F407_霸天虎V1/封装库/F407核心板整体封装/F407核心板整体封装.PcbDoc
hardware/F407_霸天虎V1/封装库/LCD_4.5液晶封装库/PCB/AD/LCD_4.5.PcbLib
hardware/F407_霸天虎V1/封装库/LCD_4.5液晶封装库/SCH/AD/LCD_4.5.SCHLIB
hardware/F407_霸天虎V1/封装库/WITI天线封装（AD+PADS版本）/WIFI_ANTENNA.PcbLib
hardware/F407_霸天虎V1/封装库/WITI天线封装（AD+PADS版本）/WIFI_ANTENNA.SchLib
hardware/F407_霸天虎V2/封装库/LCD_4.5液晶封装库/PCB/AD/LCD_4.5.PcbLib
hardware/F407_霸天虎V2/封装库/LCD_4.5液晶封装库/SCH/AD/LCD_4.5.SCHLIB
hardware/F407_霸天虎V2/封装库/WITI天线封装（AD+PADS版本）/WIFI_ANTENNA.PcbLib
hardware/F407_霸天虎V2/封装库/WITI天线封装（AD+PADS版本）/WIFI_ANTENNA.SchLib
hardware/F407_霸天虎V2/封装库/野火_F407霸天虎_V2_0_封装库/AD格式/野火_F407霸天虎_V2_0_PCB封装库_AD格式.PcbLib
hardware/F407_霸天虎V2/封装库/野火_F407霸天虎_V2_0_封装库/AD格式/野火_F407霸天虎_V2_0_原理图封装库_AD格式.SCHLIB
hardware/F407_霸天虎V2/封装库/野火_F407霸天虎_V2_0_封装库/CADENCE格式/野火_F407霸天虎_V2_0_原理图封装库_ORCAD格式.OLB
