Embedfire-stm32f407-batianhu/ebf_stm32f407_batianhu_hardware/hardware/F407_霸天虎V1/封装库/F407底板+核心板封装库/F407_MB封装库/SCH/PADS/F407_MB.c

*PADS-LIBRARY-SCH-DECALS-V9*

1086-3.3         32000 32000 97 10 97 10 4 1 0 3 0
TIMESTAMP 2017.03.28.08.09.12
"Default Font"
"Default Font"
-320  230   0 4 97 10 "Default Font"
REF-DES
-10   300   0 6 97 10 "Default Font"
PART-TYPE
-90   -320  0 6 97 10 "Default Font"
*
-90   -410  0 6 97 10 "Default Font"
*
CLOSED 5 10 0 -1
-400  200  
-400  -300 
500   -300 
500   200  
-400  200  
T-600  -200  0 0 140   20    0 2 230   0     0 16 PIN
P-520  0     0 2 -80   0     0 2 0
T700   100   0 2 140   20    0 2 230   0     0 16 PIN
P-520  0     0 2 -80   0     0 2 0
T-600  100   0 0 140   20    0 2 230   0     0 16 PIN
P-520  0     0 2 -80   0     0 2 0

1X2PIN_SMD       32000 32000 97 10 97 10 4 3 0 2 2
TIMESTAMP 2017.03.28.08.09.12
"Default Font"
"Default Font"
-70   170   0 4 97 10 "Default Font"
REF-DES
290   500   0 6 97 10 "Default Font"
PART-TYPE
-50   -130  0 6 97 10 "Default Font"
SPIL PART #
-60   -240  0 6 97 10 "Default Font"
*
CLOSED 5 10 0 -1
-150  150  
150   150  
150   50   
-150  50   
-150  150  
CLOSED 5 10 0 -1
-130  120  
-130  80   
-70   80   
-70   120  
-130  120  
CLOSED 5 10 0 -1
130   120  
130   80   
70    80   
70    120  
130   120  
T-250  100   0 0 60    10    0 2 140   10    0 16 PINSHORT
P-520  0     0 2 -80   0     0 2 0
T250   100   0 2 60    10    0 2 140   10    0 16 PINSHORT
P-520  0     0 2 -80   0     0 2 0

1_DIP            32000 32000 97 10 97 10 4 2 0 1 3
TIMESTAMP 2017.03.28.08.09.12
"Default Font"
"Default Font"
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
50    400  
100   450  
OPEN   2 10 0 -1
50    200  
0     150  
OPEN   2 10 0 -1
100   300  
-200  300  
T-400  300   0 4 140   20    0 2 230   0     0 16 PIN
P-520  0     0 2 -80   0     0 2 0
T300   300   0 6 140   20    0 2 230   0     0 16 PIN
P-520  0     0 2 -80   0     0 2 0


*END*
