Embedfire-stm32f407-batianhu/ebf_stm32f407_batianhu_hardware/(commit log)

2020-05-04 添加现有资料
2020-06-17 0617 目录&云盘
    [STM32F407ZGT6管脚汇总（含第二功能）.xlsx]
2020-07-24 目录整理
    [3215.psm, 3225.psm, F407-CORE.PcbLib, F407_CORE.SCHLIB, F407_MB.PcbLib, F407_MB.SCHLIB, F407核心板整体封装.PcbDoc, GT5688_Config_20170118_135131V100 01.txt]
2020-09-03 添加晶振手册
2020-09-04 添加文件
